bradbn/pelms-2024-s1/README.md

# pelms-2024-s1
Portable Electroluminescence Measurement System for Photovoltaic Modules - Semester 1 2024

## Cloning Repository
To clone this repository, type the following:

`git clone https://github.com/bradbn/pelms-2024-s1.git`
