bradbn/pelms-2024-s1/docs/PELMS/PELMS-2023-S1/SharePoint/Documents/Design Documentation/Software/Software Design Documentation.docx

1. Overview
2. Photo-taking algorithm

Title: "Development and Performance Evaluation of a Portable Electroluminescence Measurement System for Photovoltaic Modules: A Raspberry Pi and Image Processing Approach"

Goals:

1. **Efficient Image Capture**: Develop software that can effectively control a Raspberry Pi Camera module to capture high-quality images of photovoltaic modules under varying power conditions.

2. **Image Comparison and Analysis**: Implement image processing techniques that can accurately compare and analyze the captured images to detect differences in electroluminescence.

3. **Usability**: Create software that is user-friendly and can be operated in both automatic and manual modes, allowing for adjustable parameters like ISO, waiting time, and resolution.

4. **Performance Evaluation**: Validate the software through rigorous testing to ensure that it meets the specified performance criteria and can reliably detect defects in photovoltaic modules.

5. **Scalability**: Design the software to be easily adaptable and upgradeable for future improvements, such as capturing 12-bit images, improving image quality, and allowing for longer exposure times.

Guidelines:

1. **Modular Design**: Keep the design modular to promote easy maintenance and future enhancements.

2. **Code Quality**: Ensure the code is well-documented, maintainable, and follows good coding practices.

3. **Error Handling**: Implement robust error handling to ensure the software handles unforeseen conditions gracefully.

4. **User Interface**: Prioritize usability in the design, making sure that all features and options are intuitive and easy to understand.

5. **Performance Optimization**: Optimize the software to minimize image capture and processing time without sacrificing quality.

6. **Testing and Validation**: Regularly test and validate the software throughout its development to ensure it meets all specified goals and performance criteria.

Result:

The code successfully utilized the Raspberry Pi Camera to capture images under different power conditions, and then computed the difference between these images. The average difference was then output as an image, providing a visual representation of the variations caused by changes in power conditions. This allowed for an in-depth comparison of images taken under different power conditions, with a particular focus on the electroluminescence effect in photovoltaic modules.

The generated difference images (electroluminescence images) were found to be highly effective in highlighting defects in photovoltaic modules. The defects were visible as areas with a significant difference in electroluminescence, allowing for easy identification and further investigation.

Conclusion:

In conclusion, the project has successfully met its objectives by effectively leveraging a Raspberry Pi Camera and image processing techniques to evaluate the impact of electroluminescence on photovoltaic modules. The image comparison methodology employed not only enabled a clear understanding of the variations caused by different power conditions but also facilitated the detection of defects in the photovoltaic modules with a high degree of accuracy.

The quality of the captured images and the generated difference images were commendable, offering easy visualization and interpretation of results. The project demonstrated robustness and reliability by consistently delivering accurate results, even under varying power conditions. The user-friendly design, offering both manual and automatic modes, adds to the usability of the tool in different scenarios, enhancing its potential for real-world applications.

The satisfactory performance of the project against all benchmarked performance criteria underscores its potential utility in the field of photovoltaic module manufacturing and quality control. The capability to accurately identify defects could contribute significantly to the improvement of photovoltaic module reliability and efficiency, which is of paramount importance in the energy industry.

This project serves as a valuable proof of concept demonstrating the effectiveness of using image processing techniques for electroluminescence analysis in photovoltaic modules. Future work could focus on further improving the speed and efficiency of image processing, as well as exploring the application of more sophisticated image comparison and defect detection algorithms to enhance the accuracy and sensitivity of defect detection.

3. RF module configuration
4. GUI design
