bradbn/pelms-2024-s1/docs/PELMS/PELMS-2023-S1/SharePoint/Documents/Reports/Final Documents/Poster/Showcase Presentation.pptx

## Haha funny no longer need this Showcase Presentation: Portable Electroluminescence

Team Solar
Andrew Leong (u6283651) | Levi Zhang (u6972739)
Balaji Radhakrishnan (u7322353) | Yixin Lu (u7411857)
Bhargav Ashok (u7172176) | Zhengdao Zhou (u6706891)

## Electroluminescence of Solar Panels

- Intro into what EL for solar panels is and why its important

## Existing Methods

- Current way of doing things, requiring low lighting conditions and high cost equipment

## Project Objectives

- Problem we are trying to solve and the scope

## Method

- How project has delivered value
- Stakeholders
- Systems Engineering?

## Portable Camera System

## Current Limiter

## Prototype

## Demonstration

## Initial Results

## Rooms for Improvement

## Questions?
