bradbn/pelms-2024-s1/docs/PELMS/SMA Connectors.docx

RP-SMA Female connector on the PCB to an RP-SMA Male on the antenna base.

Want an RP-SMA Male elbow to reduce the height on the RPi.

RP-SMA Male Elbow to RP-SMA Female

https://garmade.com/products/rp-sma-male-elbow-to-rp-sma-female-rg174-rf-coaxial-adapter-cable-length-15cm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

https://mobspares.com/products/rp-sma-male-elbow-to-rp-sma-female-rg174-rf-coaxial-adapter-cable-length-15cm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

https://www.aliexpress.com/item/33004721412.html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
