bradbn/pelms-2024-s1/docs/PELMS/PELMS-2023-S1/SharePoint/Meetings/Client meetings/Meeting Note_05_05_2023.docx

Meeting Notes

Meeting Agenda –Meeting with Chris to continue building our circuit and finalise design and connections with the various components

Meeting Attendance:

Balaji Radhakrishnan (u7322353)

Bhargav Ashok (u7172176)

The other team member’s presence was not necessary since the physical circuit is being developed by the electrical team.

Meeting Notes: | Meeting Duration ~ 120 minutes

The agenda for the meeting was to start the electrical work associated with circuit.

Balaji R began by completing the connections for the Diode and Mosfet, as well as attaching the chip to the copper clad board. Bhargav A started building the various connections associated with the circuit and adding the necessary resistors, capacitors and inductors to ensure the circuit is able to ensure current can be safely passed. Below is image showing the development of the circuit connections to the chip.

Meeting Outcomes:

1. Completed initial connections to the Mosfet, Diode and chip
2. Completed the resistor, capacitor and inductors connections to the design

Current Deliverables:

Continue electrical work and complete the connections for resistor, capacitor and inductor

Finalise the design associated with the circuit

Appendix:

Below is an image of the circuit developed during the meeting

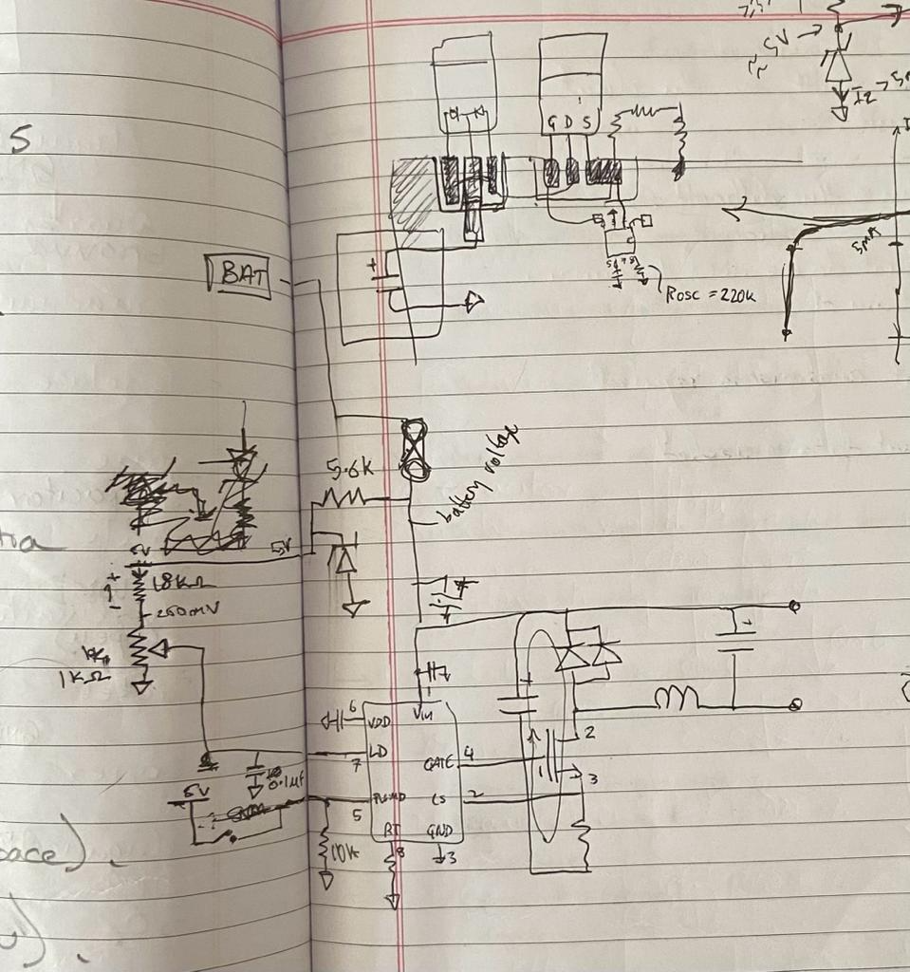
[picture p102: figure]
