bradbn/pelms-2024-s1/docs/PELMS/PELMS-2024-S1/READING/Bayer capture and processing with the Raspberry Pi HQ camera in Python _ by Eric Bezzam _ Medium.pdf

# Bayer capture and processing with the Raspberry Pi HQ camera in Python

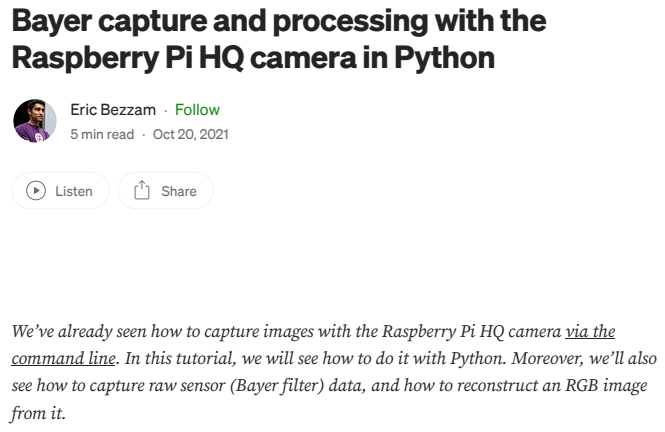
[picture p156: page 1]
Listen; Share

Eric Bezzam (https://medium.com/@bezzam?source=post_page-----8496fed9dcb7--------------------------------) · Follow (https://medium.com/m/signin?operation=register&user=Eric+Bezzam&userId=1c7c74e61a34)
5 min read · Oct 20, 2021

We’ve already seen how to capture images with the Raspberry Pi HQ camera via the
command line. In this tutorial, we will see how to do it with Python. Moreover, we’ll (https://medium.com/@bezzam/headless-raspberry-pi-hq-camera-setup-and-focusing-258ac5cca5ea) also
see how to capture raw sensor (Bayer filter) data, and how to reconstruct an RGB image
from it.

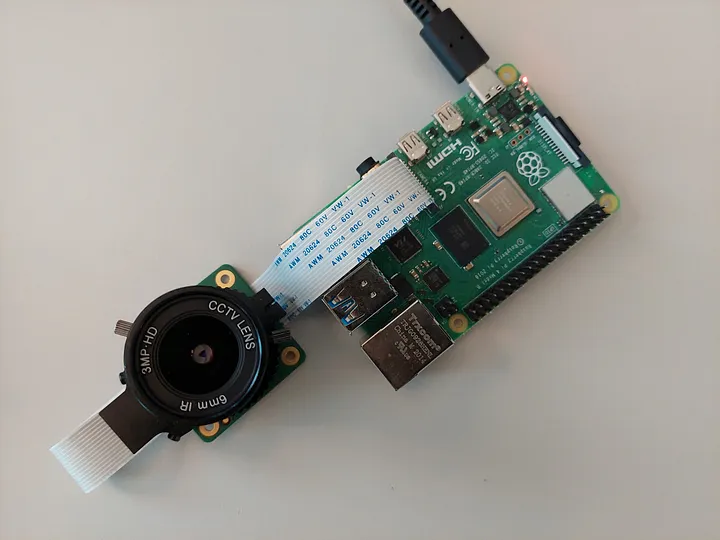
[picture p157: figure]

Before you start:

Your Raspberry Pi should be flashed (https://medium.com/@bezzam/setting-up-a-raspberry-pi-without-a-monitor-headless-9a3c2337f329) with Buster OS as Bullseye does not support the Python package ( picamerax (https://github.com/labthings/picamerax) ) used to interface with the camera!

A lens should be fitted and focused; we’ll use a 6mm CS-mount lens as shown here. (https://medium.com/@bezzam/headless-raspberry-pi-hq-camera-setup-and-focusing-258ac5cca5ea)
Image capture in Python
In a previous tutorial, (https://medium.com/@bezzam/headless-raspberry-pi-hq-camera-setup-and-focusing-258ac5cca5ea) we saw how to capture images with the Raspberry Pi HQ camera via the command line.

raspistill -o test.jpg

For automation purposes, it may be of interest to trigger acquisitions from a scripting language such as Python. To this end, the library PiCameraX (https://picamerax.readthedocs.io/en/latest/) provides some useful functionality in order to configure camera settings (e.g. resolution, frame rate, exposure, ISO, etc).

PiCameraX can be installed via pip (note that the package requires Python 3.2 or above):

pip install picamerax

The following script captures an image to a file.

If you’re working remotely, you can copy over the file as such:

scp pi@raspberrypi.local:/home/pi/test.jpg .

simple_capture.py (https://gist.github.com/ebezzam/4bdef8f5ec2e159012837bb4deba7490#file-simple_capture-py) hosted with ❤ by GitHub (https://github.com/) | view raw (https://gist.github.com/ebezzam/4bdef8f5ec2e159012837bb4deba7490/raw/6cb8713e36a2f51e55b6c80bc91ce4a446b70a5c/simple_capture.py)
1 | from time import sleep
2 | from picamerax import PiCamera
3
4 | camera = PiCamera()
5 | camera.resolution = (1024, 768)
6 | # Camera warm-up time
7 | sleep(2)
8 | camera.capture('test.jpg')

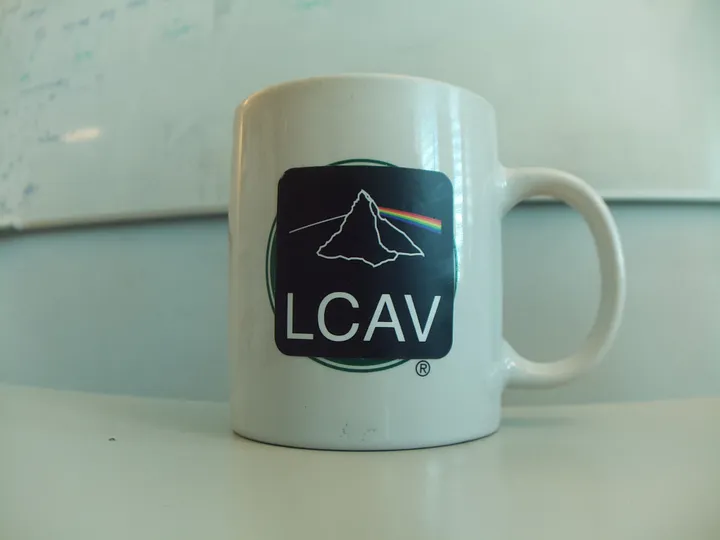
[picture p158: figure]

And that’s it! Different recipes can be found on the PiCameraX documentation page (basic (https://picamerax.readthedocs.io/en/latest/recipes1.html) and advanced). (https://picamerax.readthedocs.io/en/latest/recipes2.html)
Capturing Bayer data via Python
For the rest of this tutorial, we will focus on Bayer data capture, for which PiCameraX offers some functionality. (https://github.com/labthings/picamerax/blob/5f5255a054973cceb42460fd535e980955520e44/picamerax/array.py) Bayer data is the raw data measured by the camera sensor before any GPU processing: demosaicing, color balancing, vignette compensation, smoothing, down-scaling, etc. Wikipedia (https://en.wikipedia.org/wiki/Bayer_filter) provides a good overview about Bayer data / filters. For certain applications, we may require the raw Bayer data, as it has minimal non-linear processing and we can have full control over any subsequent processing.

A Bayer filter consists of a grid of red, green, and blue pixels with twice as many green pixels. On the HQ camera, the pixels are arranged in a BGGR pattern, as shown below.

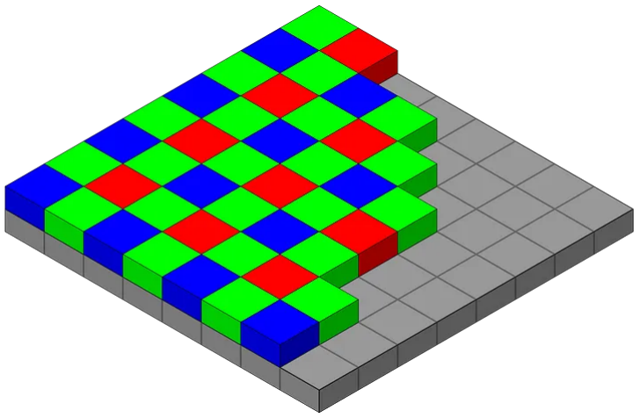
[picture p159: figure]

Source: https://en.wikipedia.org/wiki/Bayer_filter#/media/File:Bayer_pattern_on_sensor.svg

That means if you were to simply extract the red, green, and blue channels from the Bayer data in order to form an RGB image, the resulting image would be too green. Interpolation methods can be used to combine the different pixel values in order to create a more natural-looking image. This process of building a full color image from a color filter array (CFA) such as Bayer is known as demosaicing. (https://en.wikipedia.org/wiki/Demosaicing)

PiCameraX has a recipe (https://picamerax.readthedocs.io/en/latest/recipes2.html#raw-bayer-data-captures) for capturing the Bayer data and demosaicing, which we’ve modified below to have the image as a PNG file.

bayer_capture.py (https://gist.github.com/ebezzam/f3375e937d7535742e3927bd2bccf6f9#file-bayer_capture-py) hosted with ❤ by GitHub (https://github.com/) | view raw (https://gist.github.com/ebezzam/f3375e937d7535742e3927bd2bccf6f9/raw/c4902cefa5dff8863db302739595e22b72380e41/bayer_capture.py)
1 | import picamerax
2 | import picamerax.array
3 | import numpy as np
4 | from PIL import Image
5
6 | with picamerax.PiCamera() as camera:
7 | with picamerax.array.PiBayerArray(camera) as stream:
8 | camera.capture(stream, 'jpeg', bayer=True)
9 | output = (stream.demosaic() >> 2).astype(np.uint8)
10 | img = Image.fromarray(output)
11 | img.save("test_bayer.png")

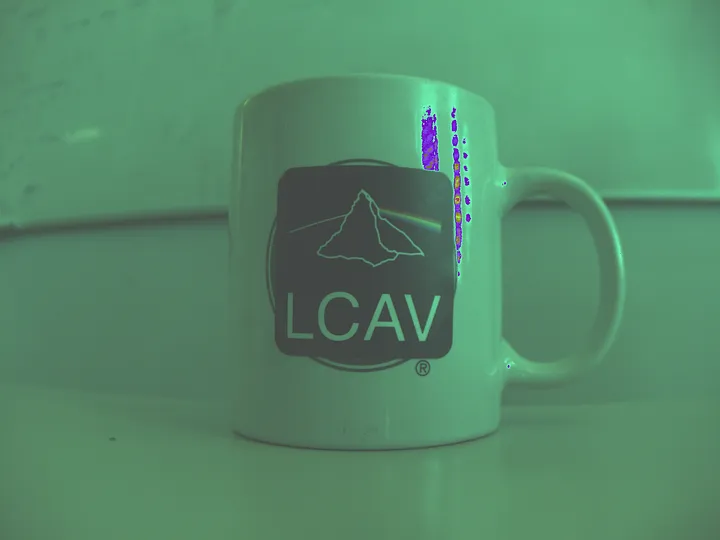
[picture p160: figure]

Not so great😞

The purple traces seem to be indicative of clipping, and we still need color balancing in order to adjust red, green, and blue levels appropriately. PiCameraX (https://en.wikipedia.org/wiki/Color_balance) doesn’t offer such functionality so we will show how to do this in order to get a natural-looking image, as well as deal with clipping.
From Bayer to RGB
We’ll have quite a few differences and additions compared to the PiCameraX recipe. Specifically we will:
Collect | uint16 | data as the HQ camera supports 12 bit raw data. Moreover, we
need to use OpenCV in order to save 16 bit RGB data. Note that OpenCV expects channels in the BGR format. (https://learnopencv.com/why-does-opencv-use-bgr-color-format/)

Use OpenCV’s demosaicing algorithm, which uses bilinear interpolation (bottom of these docs). (https://docs.opencv.org/4.5.3/d8/d01/group__imgproc__color__conversions.html) Note that OpenCV also has a particular way to define Bayer filter patterns, (https://docs.opencv.org/3.4.15/de/d25/imgproc_color_conversions.html) using the second row, second and third column sub-pixels colors to define the layout. So the conversion for our case is COLOR_BayerRG2RBG (https://docs.opencv.org/3.4.15/d8/d01/group__imgproc__color__conversions.html) .

Apply color balancing using red and blue gains estimated by the Raspberry Pi’s AWB (automatic white balance) algorithm. More info on this can be found in Section 5.7 of their documentation.

Apply a color correction matrix (CCM), Section 5.11 of the Raspberry Pi camera documentation. (https://datasheets.raspberrypi.com/camera/raspberry-pi-camera-guide.pdf)

This recipe, largely inspired by this blog (https://www.strollswithmydog.com/open-raspberry-pi-high-quality-camera-raw/) (which also provides the black level to subtract and the CCM values), can be found below.

from time import sleep
import picamerax
import picamerax.array
import numpy as np
import cv2

camera = picamerax.PiCamera()

# get gains for white balancing sleep(2)

awb_gains = camera.awb_gains camera.awb_mode = "off"
camera.awb_gains = awb_gains

# perform capture

stream = picamerax.array.PiBayerArray(camera) camera.capture(stream, "jpeg", bayer=True)

# get raw Bayer data

n_bits = 12
output = np.sum(stream.array, axis=2).astype(np.uint16)

# demosaicing

rgb = cv2.cvtColor(output, cv2.COLOR_BayerRG2RGB)

# subtract black level

black_level = 256.3
rgb = rgb - black_level

# white balance

rgb[:, :, 0] *= float(awb_gains[0]) rgb[:, :, 2] *= float(awb_gains[1])

# color correction

M = np.array(
[
[2.0659, -0.93119, -0.13421], [-0.11615, 1.5593, -0.44314], [0.073694, -0.4368, 1.3636],
]
)
rgb_flat = rgb.reshape(-1, 3, order="F")
rgb = (rgb_flat @ M.T).reshape(rgb.shape, order="F")

# clip

rgb = rgb / (2 ** n_bits - 1 - black_level) rgb[rgb > 1] = 1

Running the above recipe, we would…still not get an natural-looking image.

Perceptual adjustments
There are two reasons behind this very dark image:

Our image data is 12 bit but we are storing it as 16 bits so we are not using the full dynamic range.

Our eyes do not perceive light the way cameras do, i.e. we perceive light in a non-linear fashion as shown below.

bayer capture processed py hosted with ❤ by GitHub | view raw
48 | rgb[rgb > 1] = 1
49 | rgb[rgb < 0] = 0
50 | output = (rgb * (2 ** n_bits - 1)).astype(np.uint16)
51
52 | # save
53 | cv2.imwrite("test_bayer_corrected.png", cv2.cvtColor(output, cv2.COLOR_RGB2BGR))

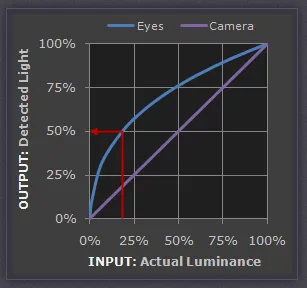
[picture p161: figure]

Source: https://www.cambridgeincolour.com/tutorials/gamma-correction.htm

In order to account for this perception mismatch, we need to apply gamma correction and normalize before visualizing the image. (https://www.cambridgeincolour.com/tutorials/gamma-correction.htm)

Applying solely normalization produces a much more pleasing image.

save_normalized_image.py (https://gist.github.com/ebezzam/77fa3c5e2c9ad3691ccdcd341a2218c0#file-save_normalized_image-py) hosted with ❤ by GitHub (https://github.com/) | view raw (https://gist.github.com/ebezzam/77fa3c5e2c9ad3691ccdcd341a2218c0/raw/98983f43431937cd8a1edfede8adcd71bb65f99f/save_normalized_image.py)

import cv2
from PIL import Image
import numpy as np

# need OpenCV to open 16 bit RGB

fp = "test_bayer_corrected.png"
img = cv2.imread(fp, cv2.IMREAD_UNCHANGED) img = cv2.cvtColor(img, cv2.COLOR_BGR2RGB)

# normalize and save

img_float = img / img.max()
data = 255 * img_float
img_uint8 = data.astype(np.uint8) Image.fromarray(img_uint8).save("normalized.png")

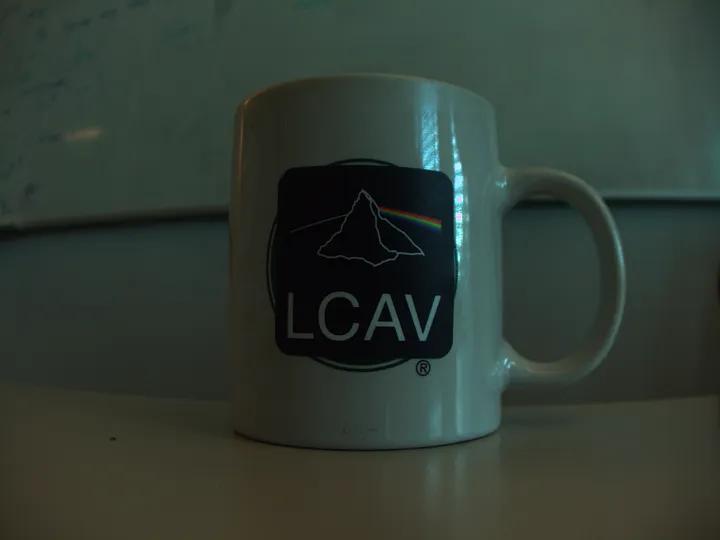
[picture p162: figure]

But the image is still rather dark, and the colors don’t match our real world perception.

Gamma correction will remedy this discrepancy. To this end, there are some simple approaches, but we will use the Rec. 709 standard: (https://lindevs.com/apply-gamma-correction-to-an-image-using-opencv/)

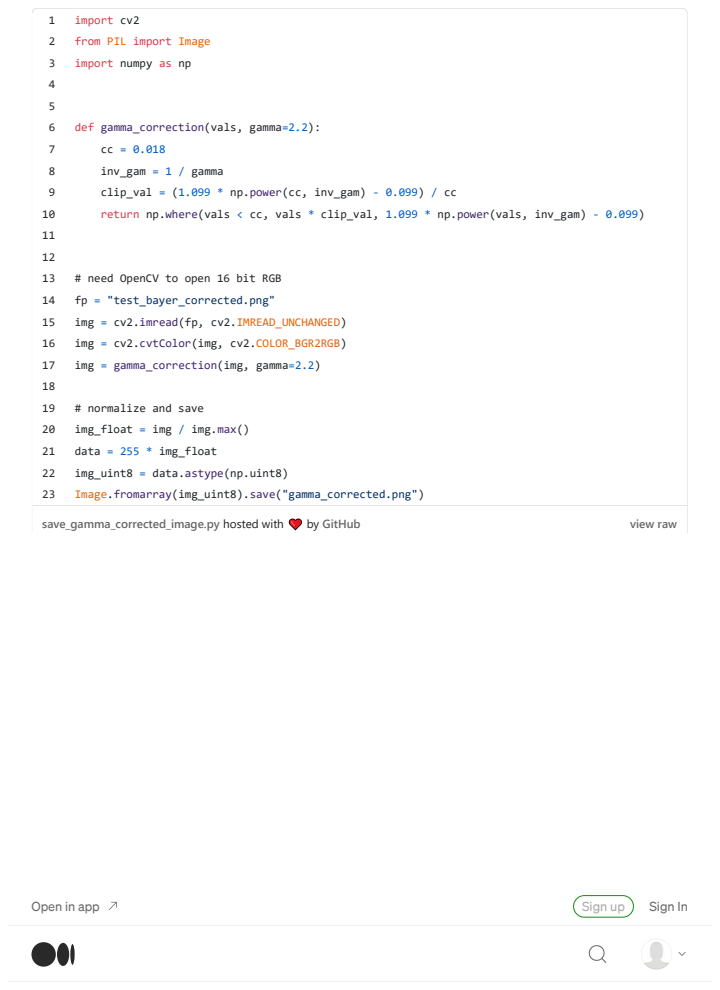
[picture p163: page 12]
save_gamma_corrected_image.py hosted with ❤ by GitHub; view raw; import cv2; from PIL import Image; import numpy as np; def gamma_correction(vals, gamma=2.2):; inv_gam = 1 / gamma; clip_val = (1.099 * np.power(cc, inv_gam) - 0.099) / cc; return np.where(vals < cc, vals * clip_val, 1.099 * np.power(vals, inv_gam) - 0.099); # need OpenCV to open 16 bit RGB; fp = "test_bayer_corrected.png"; img = cv2.imread(fp, cv2.IMREAD_UNCHANGED); img = cv2.cvtColor(img, cv2.COLOR_BGR2RGB)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

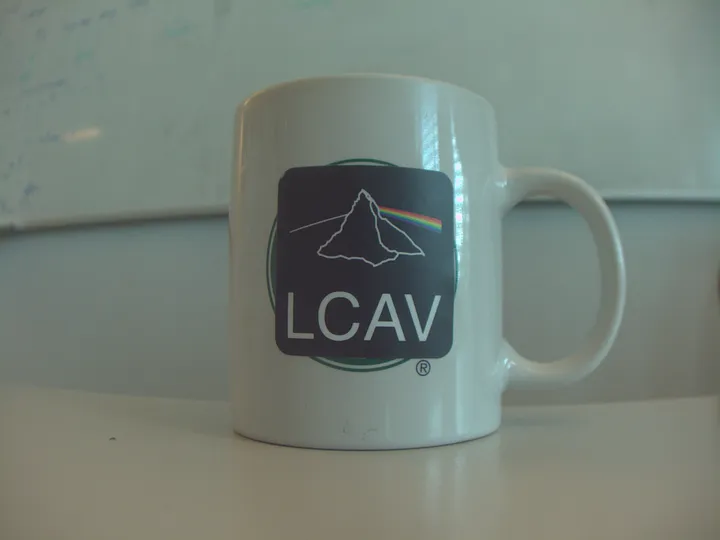
[picture p164: figure]

That looks much better😎
Extra links
Official post by Raspberry Pi: https://www.raspberrypi.com/news/processing-raw-image-files-from-a-raspberry-pi-high-quality-camera/ (https://www.raspberrypi.com/news/processing-raw-image-files-from-a-raspberry-pi-high-quality-camera/)

Stolls with my Dog has also done a very thorough analysis of the HQ camera performance: https://www.strollswithmydog.com/pi-hq-cam-sensor-performance/

Getting raw Bayer data without PiCameraX on the Bullseye OS: https://www.raspberrypi.com/documentation/accessories/camera.html#raw-image-capture (https://www.raspberrypi.com/documentation/accessories/camera.html#raw-image-capture)

Bayer (https://medium.com/tag/bayer?source=post_page-----8496fed9dcb7---------------bayer-----------------) | Python (https://medium.com/tag/python) | Raspberry Pi (https://medium.com/tag/raspberry-pi) | Color Correction (https://medium.com/tag/color-correction) | Gamma Correction (https://medium.com/tag/gamma-correction)

Written by Eric Bezzam (https://medium.com/@bezzam?source=post_page-----8496fed9dcb7--------------------------------)

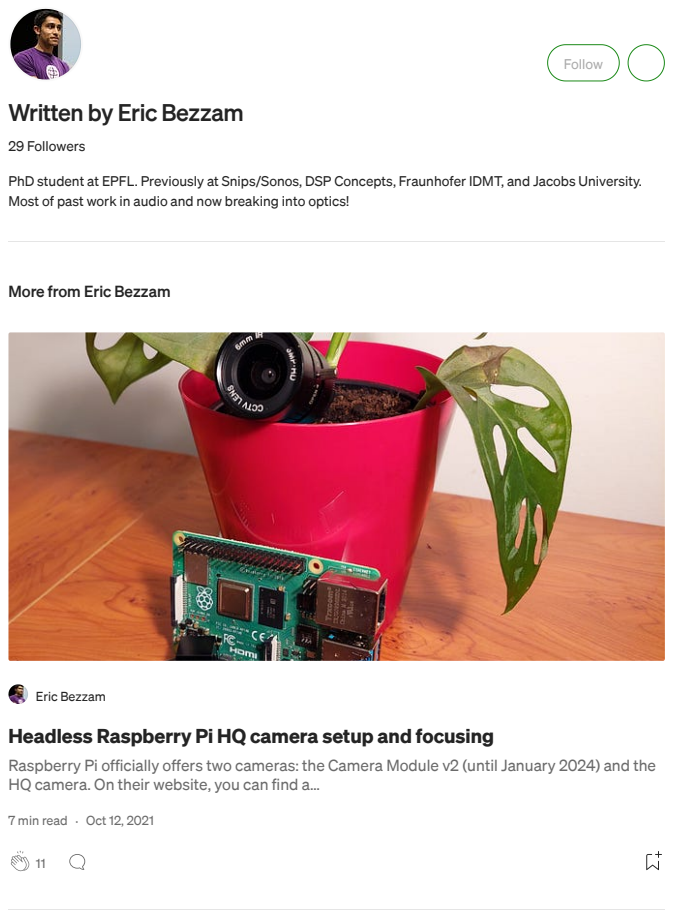
[picture p165: page 14]
Follow; 29 Followers

PhD student at EPFL. Previously at Snips/Sonos, DSP Concepts, Fraunhofer IDMT, and Jacobs University.
Most of past work in audio and now breaking into optics!

More from Eric Bezzam

Eric Bezzam (https://medium.com/@bezzam)
Headless Raspberry Pi HQ camera setup and focusing
Raspberry Pi officially offers two cameras: the Camera Module v2 (until January 2024) and the
HQ camera. On their website, you can find a…

7 min read · Oct 12, 2021 (https://medium.com/@bezzam/headless-raspberry-pi-hq-camera-setup-and-focusing-258ac5cca5ea)

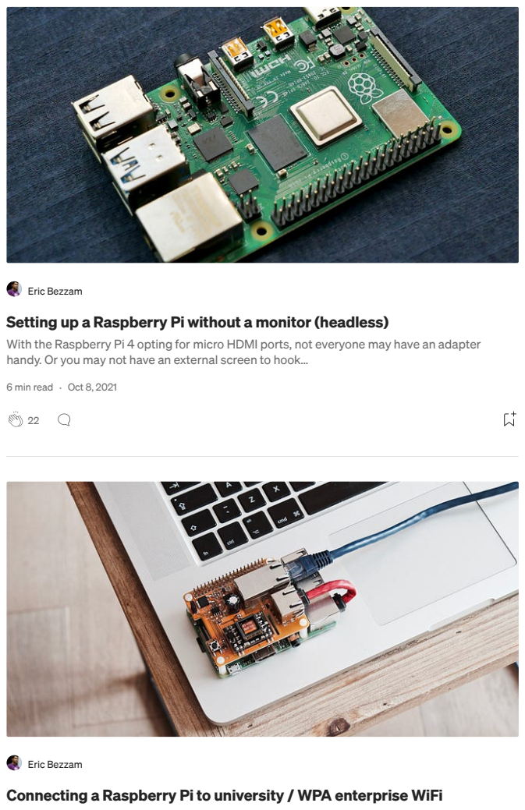
[picture p166: page 15]

Eric Bezzam (https://medium.com/@bezzam)
Setting up a Raspberry Pi without a monitor (headless)
With the Raspberry Pi 4 opting for micro HDMI ports, not everyone may have an adapter
handy. Or you may not have an external screen to hook…

6 min read · Oct 8, 2021 (https://medium.com/@bezzam/setting-up-a-raspberry-pi-without-a-monitor-headless-9a3c2337f329)

Connecting a Raspberry Pi to university / WPA enterprise WiFi (https://medium.com/@bezzam/connecting-a-raspberry-pi-to-university-wpa-enterprise-wifi-532d4b203056)

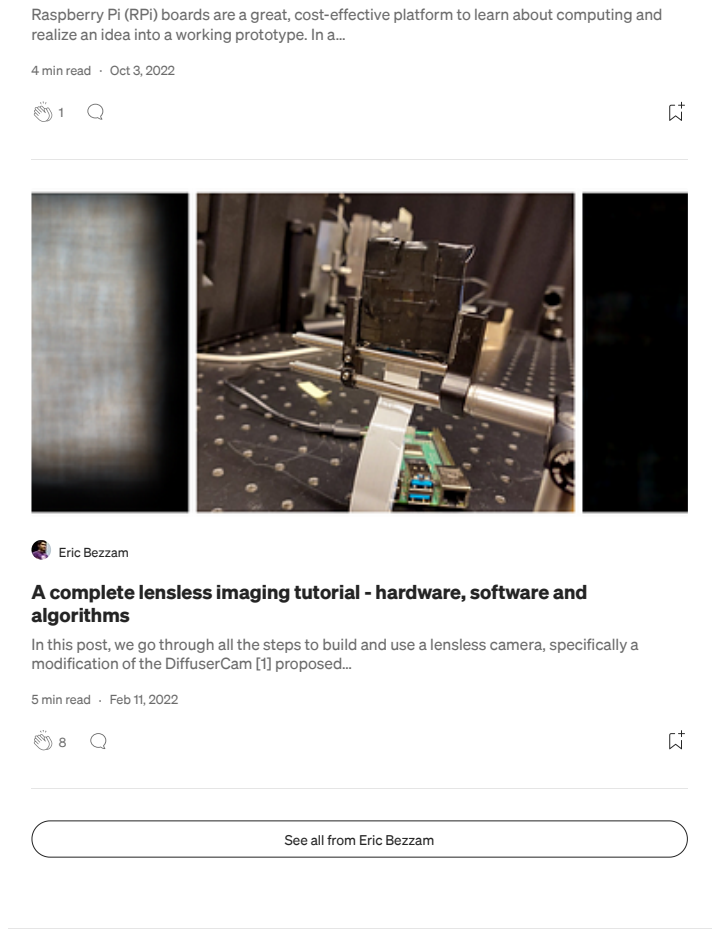
[picture p167: page 16]

Raspberry Pi (RPi) boards are a great, cost-effective platform to learn about computing and
realize an idea into a working prototype. In a…

4 min read · Oct 3, 2022 (https://medium.com/@bezzam/connecting-a-raspberry-pi-to-university-wpa-enterprise-wifi-532d4b203056)

Eric Bezzam (https://medium.com/@bezzam)
A complete lensless imaging tutorial - hardware, software and
algorithms
In this post, we go through all the steps to build and use a lensless camera, specifically a
modification of the DiffuserCam [1] proposed…

5 min read · Feb 11, 2022 (https://medium.com/@bezzam/a-complete-lensless-imaging-tutorial-hardware-software-and-algorithms-8873fa81a660)

See all from Eric Bezzam (https://medium.com/@bezzam?source=post_page-----8496fed9dcb7--------------------------------)

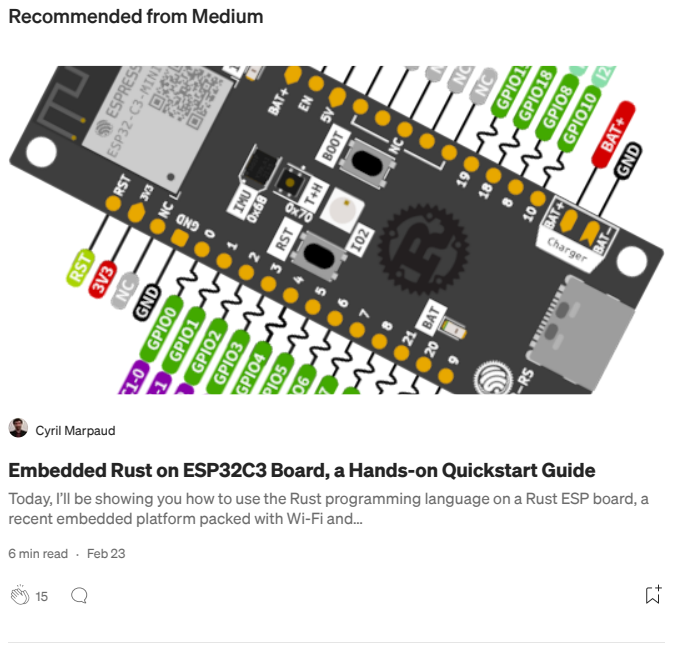
[picture p168: page 17]

Recommended from Medium

Cyril Marpaud (https://medium.com/@cyril.marpaud)
Embedded Rust on ESP32C3 Board, a Hands-on Quickstart Guide
Today, I’ll be showing you how to use the Rust programming language on a Rust ESP board, a
recent embedded platform packed with Wi-Fi and…

6 min read · Feb 23 (https://medium.com/@cyril.marpaud/embedded-rust-on-esp32c3-board-a-hands-on-quickstart-guide-a20fe5ff9b4b)

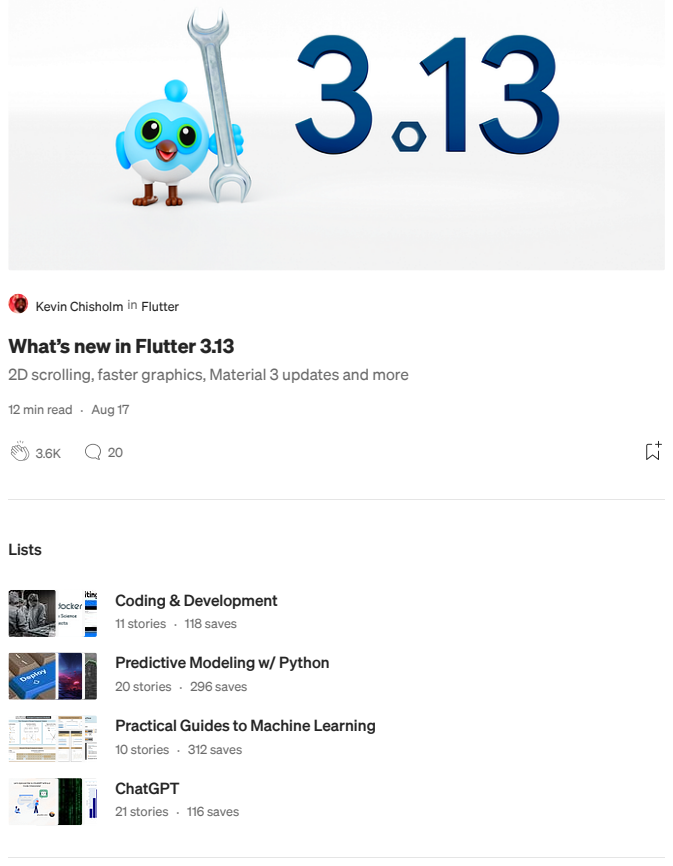
[picture p169: page 18]
Lists; Coding & Development; 11 stories · 118 saves; ChatGPT; 21 stories · 116 saves

Kevin Chisholm (https://medium.com/@kevinchisholm) in Flutter (https://medium.com/flutter)
What’s new in Flutter 3.13
2D scrolling, faster graphics, Material 3 updates and more

12 min read · Aug 17 (https://medium.com/flutter/whats-new-in-flutter-3-13-479d9b11df4d)

Predictive Modeling w/ Python
20 stories · 296 saves (https://medium.com/@ben.putney/list/predictive-modeling-w-python-e3668ea008e1)

Practical Guides to Machine Learning
10 stories · 312 saves (https://medium.com/@destingong/list/practical-guides-to-machine-learning-a877c2a39884)

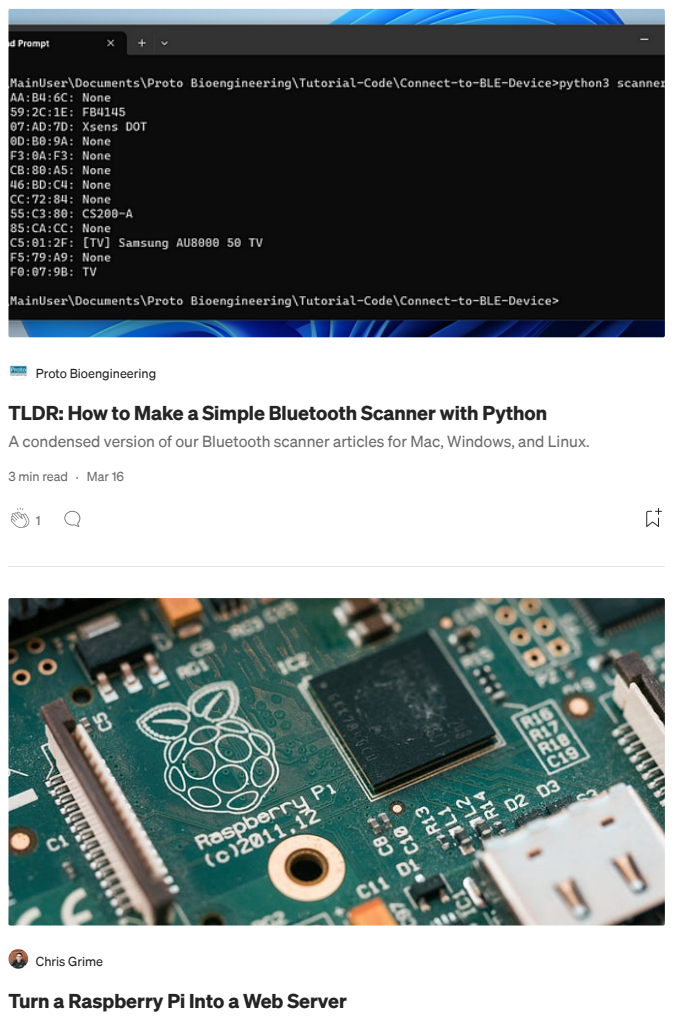
[picture p170: page 19]

Proto Bioengineering (https://medium.com/@protobioengineering)
TLDR: How to Make a Simple Bluetooth Scanner with Python
A condensed version of our Bluetooth scanner articles for Mac, Windows, and Linux.

3 min read · Mar 16 (https://medium.com/@protobioengineering/tldr-how-to-make-a-simple-bluetooth-scanner-with-python-99023152110e)

Chris Grime (https://medium.com/@chrisgrime)
Turn a Raspberry Pi Into a Web Server (https://medium.com/@chrisgrime/turn-a-raspberry-pi-into-a-web-server-ea7f395e6fe8)

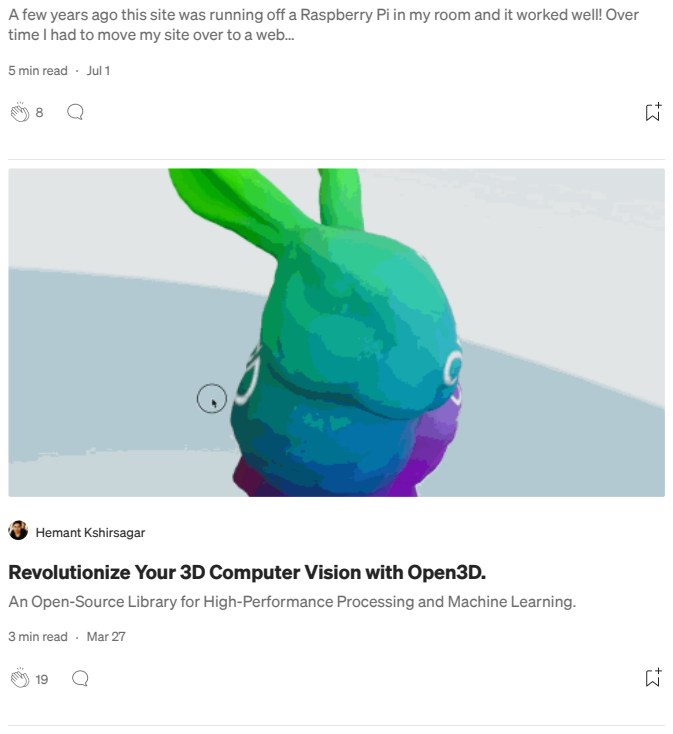
[picture p171: page 20]

A few years ago this site was running off a Raspberry Pi in my room and it worked well! Over
time I had to move my site over to a web…

5 min read · Jul 1 (https://medium.com/@chrisgrime/turn-a-raspberry-pi-into-a-web-server-ea7f395e6fe8)

Hemant Kshirsagar (https://medium.com/@hemantkshirsagar8)
Revolutionize Your 3D Computer Vision with Open3D.
An Open-Source Library for High-Performance Processing and Machine Learning.

3 min read · Mar 27 (https://medium.com/@hemantkshirsagar8/open3d-an-open-source-3d-computer-vision-library-ff65bae4f1b6)

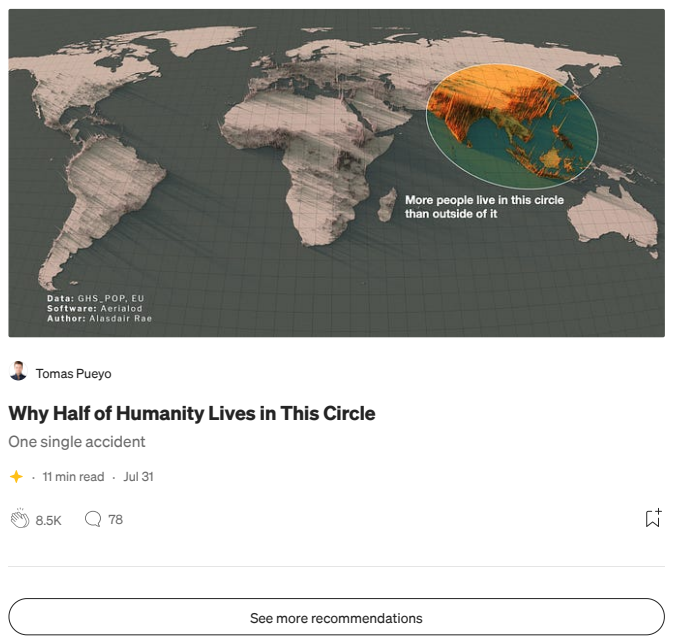
[picture p172: page 21]

Tomas Pueyo (https://medium.com/@tomaspueyo)
Why Half of Humanity Lives in This Circle
One single accident

· 11 min read · Jul 31 (https://medium.com/@tomaspueyo/why-half-of-humanity-live-in-this-circle-2c25be0994ce)

See more recommendations (https://medium.com/?source=post_page-----8496fed9dcb7--------------------------------)
