bradbn/pelms-2024-s1/docs/PELMS/PELMS-2023-S1/SharePoint/Documents/Reports/Final Documents/Final Team Review/Final Team Review.pdf

## Development of a Portable Electroluminescence Measurement System for Photovoltaic Modules

### Final Team Review

Team Solar:

Andrew Leong (u6283651)

Balaji Radhakrishnan (u7322353)

Bhargav Ashok (u7172176)

Levi Zhang (u6972739)

Yixin Lu (u7411857)

Zhengdao Zhou (u6706891)

i

## Table of Contents

## 1. Grade Band Recommendation

The team recommends a grade band of D-HD, specifically 80±5. The team views the overall work done by the team as “Acceptable to Exemplary”, leaning more on the “Exemplary” half. This is based on the analysis of the team’s performance shown in this document. To summarise the project, the team has produced an iterated and fully functional prototype that satisfies the requirements of the project. The team achieved this through informed and timely decision-making paired with excellent teamwork, and effective internal and external communications to support the development of the project. Furthermore, throughout the duration of the project, the team has implemented a regular and systematic reflection process that promotes diverse contributions and ideas. Lastly, the team has embraced the TechLauncher opportunity and has produced an informative, easy to read, and detailed showcase poster that showcases the prototype made by the team. To summarise the assessment of the project throughout the semester, the Audit indications for each of the 3 Audits are as follows:
Audit | Indicator
1 | Acceptable without reservations
2 | Acceptable without reservations
3 | Acceptable without reservations
The indicators given for each criterion in each audit are summarised below. The indicators have ranged from “Acceptable” to “Acceptable to Exemplary”. After reviewing all the work done by the team, the final recommendations in this document for each criterion range from “Acceptable” to “Exemplary”. This is also summarised below.
Criteria | Audit 1 | Audit 2 | Audit 3 | Recommendation
Project Output | Acceptable (2) | Acceptable (2) | Acceptable (2) | Acceptable to Exemplary (2.5)
Decision Making | Acceptable (2) | Acceptable to Exemplary (2.5) | Acceptable to Exemplary (2.5) | Acceptable (2)
Teamwork | Acceptable (2) | Acceptable to Exemplary (2.5) | Acceptable to Exemplary (2.5) | Acceptable to Exemplary (2.5)
Communication | Acceptable (2) | Acceptable to Exemplary (2.5) | Acceptable (2) | Acceptable to Exemplary (2.5)
Reflection | NA | Acceptable to Exemplary (2.5) | Acceptable (2) | Acceptable to Exemplary (2.5)
Design Visualisation | NA | NA | Acceptable to Exemplary (2.5) | Exemplary (3)
Average | Acceptable (2) | Acceptable (2.4) | Acceptable (2.25) | Acceptable to Exemplary (2.5)

Scoring system to determine indicator: Baseline = 1, Acceptable = 2, Exemplary = 3

## 2. Project Output

Based on the criteria, the team views Project Output on an “Acceptable to Exemplary” level. This is because the team has designed a technical solution, (https://anu365.sharepoint.com/:f:/s/PortableELdeviceProject/EvQWbpjs0pJOsftg4p_D9MgBEOkHponi8Z745BOjIGUilg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) built a fully functional prototype with 2 iterations, (https://anu365.sharepoint.com/:f:/s/PortableELdeviceProject/Eoc-iB0crvFNoao1u1XH4a8B1kk-3fmiuuEpKuHgtan8ag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) and presented the prototype to the client. (https://anu365.sharepoint.com/:w:/s/PortableELdeviceProject/EX5XOumdyPhItu-ioBck_MkBh3wD7E5bSjJZx5mDuR2bPQ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) The prototype has been tested by the team, (https://anu365.sharepoint.com/:w:/s/PortableELdeviceProject/EeiCXKnrMuhPqkqb3clWI6ABm7-c48Y0UzBP-9WEu32e9Q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) consulting electrical engineer, and client (technical expert) who have endorsed the system (https://anu365.sharepoint.com/:w:/s/PortableELdeviceProject/EX5XOumdyPhItu-ioBck_MkBh3wD7E5bSjJZx5mDuR2bPQ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) and its outputs twice. Furthermore, the prototype will be validated against the requirements in the technical report using the TPMs (https://anu365.sharepoint.com/:w:/s/PortableELdeviceProject/EW6kXEsJgw1MtgVOZHuq4oUB4-NetXl08SbPeES7-XkNrA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) but the document has not been finalised yet. Finally, the prototype surpasses the crash goals and met half of the stretch goals. (https://anu365.sharepoint.com/:w:/s/PortableELdeviceProject/ETmNM39qWipAvuR9MBurf-wBB3p5IgDRSEnYhcRk3RpKQg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) This is because the solution was designed following a systems engineering framework (https://anu365.sharepoint.com/:w:/s/PortableELdeviceProject/EW6kXEsJgw1MtgVOZHuq4oUB4-NetXl08SbPeES7-XkNrA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) where the system requirements (subsystem requirements encapsulated within high level requirements) were defined early, followed by design and construction to meet those requirements, and then by verifying the results against the requirements. The criteria that do not apply to the team are regarding the commercialisation, publication, grant funding, external validation report, and conference presentation. This is because the team does not own the IP (https://anu365.sharepoint.com/:f:/s/PortableELdeviceProject/EmUgFAes4pdMpxZanxT0aW0BLqX25ZbzKsxKDGuc_MDKkw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) to the system and therefore cannot produce any publications or commercialise the solution to receive funding, present at conferences or get external validation reports. The only criteria not met by the team is the real-world user testing and validation. This is because the team completed prototyping towards the end of the project and had no opportunity to perform real-world user testing.

## 3. Decision Making

Based on the criteria, the team views Decision Making on an “Acceptable” level. This is because the team has used a systematic method for recording decisions through clear and concise meeting minutes. (https://anu365.sharepoint.com/sites/PortableELdeviceProject/Shared%20Documents/Repository%20Documents/Meetings) Furthermore, the team has exhibited transparent communication within the team and with the client, (https://anu365.sharepoint.com/sites/PortableELdeviceProject/Shared%20Documents/Repository%20Documents/Meetings/Client%20meetings) teaching staff, and shadow by being open about the state of the project and any challenges faced such as the unexpected complexity of current regulator. The team has a centralised group chat for internal communication, with much of the external communication facilitated through the Project Coordinator. The team has also utilised systemic document revisions. (https://anu365.sharepoint.com/sites/PortableELdeviceProject/Shared%20Documents/Repository%20Documents/Archives) Furthermore, the team executed this project through the use of a systems engineering V-model (https://anu365.sharepoint.com/sites/PortableELdeviceProject/Shared%20Documents/Repository%20Documents/Documents/Reports/Systems%20Engineering%20Document.docx) that guided decision-making as decisions always related to the requirements. The team also had an inclusive decision-making process as there was feedback in Audit 1 (https://anu365.sharepoint.com/sites/PortableELdeviceProject/Shared%20Documents/Repository%20Documents/Audits/Audit%201/Team%20Solar%20Audit%201%20Feedback%20R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) about the need for a better internal process. The team then committed to consulting with everybody before making a decision (https://anu365.sharepoint.com/sites/PortableELdeviceProject/Shared%20Documents/Repository%20Documents/Meetings/Team%20meetings) as opposed to only the sub-team focused on the task. The criteria that the team did not meet was our decision-making process aligning with relevant standards, however, the team did ensure the components used aligned with relevant standards. This is because the team had operated on a system agreed upon by the team as detailed in the ConOps. (https://anu365.sharepoint.com/sites/PortableELdeviceProject/Shared%20Documents/Repository%20Documents/Audits/Audit%201/Concept%20of%20Operations_V2.docx) The team also did not utilise a decision log and recorded decisions only in meeting minutes.

## 4. Teamwork

Based on the criteria, the team views Teamwork on an “Acceptable to Exemplary” level. This is because early on in the project, the team designated specialist roles and defined the responsibilities by embracing the diverse skill set of each member. (https://anu365.sharepoint.com/sites/PortableELdeviceProject/Shared%20Documents/Repository%20Documents/Audits/Audit%201/Concept%20of%20Operations_V2.docx) Furthermore, the team agreed that the roles were not set in stone as members would rotate around the team dependent on which area required more support. The team also defined a conflict resolution style (https://anu365.sharepoint.com/sites/PortableELdeviceProject/Shared%20Documents/Repository%20Documents/Audits/Audit%201/Concept%20of%20Operations_V2.docx) early on but was lucky to not require it. The team began to build support around the project from experts as early as 10th March (Week 3). (https://anu365.sharepoint.com/sites/PortableELdeviceProject/Shared%20Documents/Repository%20Documents/Meetings/Client%20meetings/Meeting%20Note_10_03_2023.docx) This process allowed team members to grow and develop new skills. An excellent example of this is when Balaji who has a Mechanical background (https://u6283651.wixsite.com/luminescent/theteam) had the opportunity to learn soldering from the consulting electrical engineer. As such, Balaji ended up working primarily on the electrical component which transcends his background. (https://anu365.sharepoint.com/sites/PortableELdeviceProject/Shared%20Documents/Repository%20Documents/Meetings/Client%20meetings/Meeting%20Note_03_05_2023.docx) The team faced failures during the prototyping phase. The team embraces the failures as an opportunity to learn such as when the camera algorithm was not working as intended and when the current regulator had a heating issue. The team solved each issue as a team and through guidance from the established support network of experts. (https://anu365.sharepoint.com/sites/PortableELdeviceProject/Shared%20Documents/Repository%20Documents/Meetings/Client%20meetings/Meeting%20Note_10_05_2023.docx) The only criteria not met by the team was reducing uncertainty as the team operated in two sub-teams for the prototyping process and only collaborated towards the end, increasing the risk of non-integration.

## 5. Communication

Based on the criteria, the team views Communication on an “Acceptable-Exemplary” level. This is because the team believes they have displayed transparent, relevant, timely, (https://anu365.sharepoint.com/:f:/s/PortableELdeviceProject/EjZlpGgrjjNAsti9WQHueykBstz7aLVZv4q9tdzYRbe-jg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)

professional, respectful, and effective communication with all stakeholders. (https://anu365.sharepoint.com/:f:/s/PortableELdeviceProject/EjZlpGgrjjNAsti9WQHueykBstz7aLVZv4q9tdzYRbe-jg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) The team also utilises a systems vocabulary in all documents (https://anu365.sharepoint.com/:f:/s/PortableELdeviceProject/En7LODS6IWRPvkaLmvwSAZIBUgBt842cFSmqoSUwA5t5Fg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) and whenever talking about the project as evident in the tutorials and in the meeting minutes. (https://anu365.sharepoint.com/:f:/s/PortableELdeviceProject/EjZlpGgrjjNAsti9WQHueykBstz7aLVZv4q9tdzYRbe-jg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) For communication with stakeholders, the Project Coordinator has been tasked with facilitating the process. This enables professional communication as there is a sole person of contact which removes any confusion. Furthermore, the team utilises systematic process such as scheduled meetings with all stakeholders and through consistent modes of communication such as emails and MS Teams. From the beginning of the project, the team has created a shared vision (https://anu365.sharepoint.com/:p:/s/PortableELdeviceProject/ERyY0lC-l9xMqLlC3LmRd-QBFE-jqLmwYoOr_l_PnkWbDw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) of the project through consultation with the client. This resulted in trust being built with the most important stakeholder. The criteria not met by the team include the common mental models of practice because members operated best at their own pace and method but would come together and finalise the work as a team. Next, empowering members to engage with new audiences was also not achieved as there was no opportunity to engage with more external stakeholders.

## 6. Reflection

Based on the criteria, the team views Reflection on an “Acceptable-Exemplary” level. This is because the team has a system for reflection and acting on feedback. The team achieves this through the feedback response documents for Audit 1 (https://anu365.sharepoint.com/:x:/s/PortableELdeviceProject/EQdGeAx7SRNLjjdi_ipPsOUBd4l3q1ZKwP09ypyYj01RpQ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) and 2. (https://anu365.sharepoint.com/:x:/s/PortableELdeviceProject/ETFuamvw1qlNt3o21RT7BpEBmJpwo6iqsYmRv5RSlI1mQg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) In this document, the team analyses and summarises all the feedback given during the Audit process and responds to each one. The team either acts on the feedback immediately, agrees to act on the feedback, or rejects the feedback due to relevance. In this process, the team respects the viewpoints of all members as well as the shadow and teach staff who gave feedback through open discussion. Furthermore, the team consults with the client and electrical engineer (https://anu365.sharepoint.com/:f:/s/PortableELdeviceProject/Elaha2Veb-NPp8PWUfBZqFgB60ga_5SphIiH1gDQAqfZnA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) for advice regarding the feedback received. This allows for mentoring and gaining external validation for how well the team is progressing. The team also actively engages with the other teams and clients during the tutorial to provide any feedback where possible through open discussions. The only criteria not met by the team is the additional review process that includes external stakeholders. The team had initially planned on iterating the prototype after conducting user testing with ANU Solarcar to determine how functional and user friendly the system is. However, the client stated that it would only be done if a functioning system was completed in time but as the prototype phase taking longer than expected, this was not achieved.

## 7. Design Visualisation

Based on the criteria, the team views Design Visualisation on an “Exemplary” level. This is because the showcase poster (https://anu365.sharepoint.com/:b:/s/PortableELdeviceProject/ETj4-YrcmaRKhXOzDAQ8jjkBe7b6WZY6Ru83IfhG9QD_8A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) designed by the team clearly states the motivations for the project, the work done and results achieved, and details the opportunities for new audiences in a coherent, uncluttered, and visually pleasing manner. In the poster, the team also highlights which stakeholders the project delivers value to and complements the information with a functional physical prototype. In the poster, the team has built a story that flows from the current pains of the stakeholders to the accomplishments of the team, and to the opportunities allowed for by the designed solution. This story is told in as non-technical language as possible to appeal to a broad audience and allows for discussions to occur with the team, supplemented by physical prototypes and demonstration videos, to help build an understanding within the new audiences. Furthermore, the team iterated on the poster (https://www.canva.com/design/DAFi8uVkguM/3pyQNzxX5gXxXdIzKEhu_g/edit) to produce a concise and informative poster. The criteria that do not apply to the team is the demonstrates individual contributions criterion as a techlauncher poster should focus more on the holistic work done by the team, and the acts on opportunities for new audiences as the team is able to commercialise the product due to the IP being owned by the client.

Supporting Evidence
Project Output
- Technical Solution: Design Documentation (https://anu365.sharepoint.com/:f:/s/PortableELdeviceProject/EvQWbpjs0pJOsftg4p_D9MgBEOkHponi8Z745BOjIGUilg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)
- Fully functional 2 prototypes: Results (https://anu365.sharepoint.com/:f:/s/PortableELdeviceProject/Eoc-iB0crvFNoao1u1XH4a8B1kk-3fmiuuEpKuHgtan8ag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)
- Presented prototype 1 to client, validated by client and experts: Meeting minutes 15_05_2023.docx (https://anu365.sharepoint.com/:w:/s/PortableELdeviceProject/EX5XOumdyPhItu-ioBck_MkBh3wD7E5bSjJZx5mDuR2bPQ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)
- Tested by team: Meeting minutes 14_05_2023.docx (https://anu365.sharepoint.com/:w:/s/PortableELdeviceProject/EeiCXKnrMuhPqkqb3clWI6ABm7-c48Y0UzBP-9WEu32e9Q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)
- Systems Engineering Framework: Systems Engineering Document.docx (https://anu365.sharepoint.com/:w:/s/PortableELdeviceProject/EW6kXEsJgw1MtgVOZHuq4oUB4-NetXl08SbPeES7-XkNrA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)
- IP agreement: IP Agreement (https://anu365.sharepoint.com/:f:/s/PortableELdeviceProject/EmUgFAes4pdMpxZanxT0aW0BLqX25ZbzKsxKDGuc_MDKkw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)

Decision Making

- Meeting minutes : Meetings (https://anu365.sharepoint.com/:f:/s/PortableELdeviceProject/EjZlpGgrjjNAsti9WQHueykB9ZxyTYLF9lR92RQSy7w-tg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)
Centralised group chat | Transparent communication with the team and client, facilitated by project co-ordinator Andrew Leong

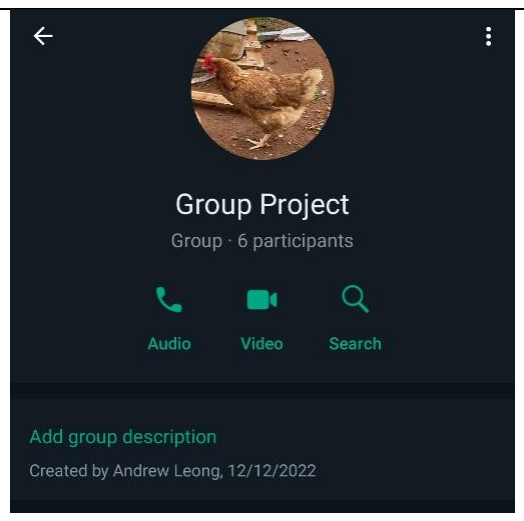
[picture p173: figure]
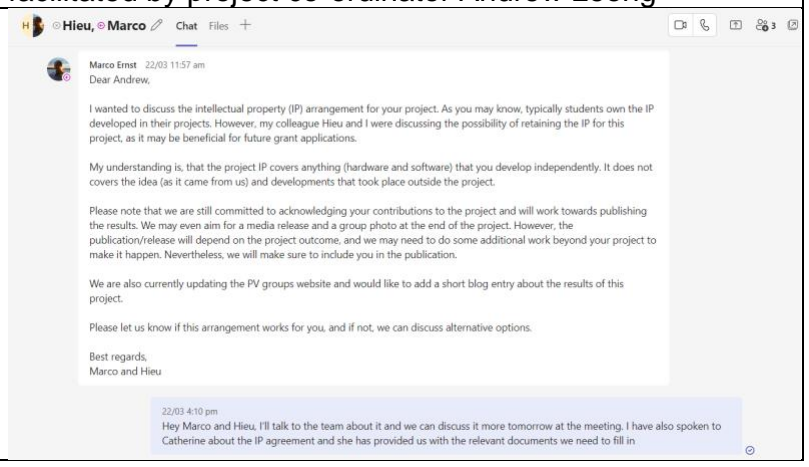
[picture p174: figure]

- Document revision: Archives (https://anu365.sharepoint.com/:f:/s/PortableELdeviceProject/ElB5jKOlBRhDh6uxH15I_FwBvGNifPKFpD_2w4w1omBNcw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)
- System engineering V-Model: Systems Engineering Document.docx (https://anu365.sharepoint.com/:w:/s/PortableELdeviceProject/EW6kXEsJgw1MtgVOZHuq4oUBj-1ZYOthkqZe2ekhR4kVqQ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)
- Decision making process for feedback audit 1: Team Solar Audit 1 Feedback Response.xlsx (https://anu365.sharepoint.com/:x:/s/PortableELdeviceProject/EQdGeAx7SRNLjjdi_ipPsOUB7Mll2pL836L-HOvRfnH32g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)
- Making a decision: Team meetings (https://anu365.sharepoint.com/:f:/s/PortableELdeviceProject/EuPXh58dGHFBkmqoJM7Lrt4B40UEYmuKO9xaoNbWZEqb5Q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)
- ConOps: Concept of Operations_V2.docx (https://anu365.sharepoint.com/:w:/s/PortableELdeviceProject/ETmNM39qWipAvuR9MBurf-wBzu14Pwa_Fnz8mBw9upJbcw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)

Teamwork

- Specialist roles and defined the responsibilities by embracing the diverse skill set of each member: Concept of Operations_V2.docx (https://anu365.sharepoint.com/:w:/s/PortableELdeviceProject/ETmNM39qWipAvuR9MBurf-wBzu14Pwa_Fnz8mBw9upJbcw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)
- Conflict resolution style: Concept of Operations_V2.docx (https://anu365.sharepoint.com/:w:/s/PortableELdeviceProject/ETmNM39qWipAvuR9MBurf-wBzu14Pwa_Fnz8mBw9upJbcw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)
- From experts as early as 10th March (Week 3): Meeting Note_10_03_2023.docx (https://anu365.sharepoint.com/:w:/s/PortableELdeviceProject/ER0vzaapu7RJphI1XjWHFc8BWsPSLvj7xMVCgE4EfLcabQ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)
- Mechanical Background: Landing page (https://u6283651.wixsite.com/luminescent/theteam)
- Balaji ended up working primarily on the electrical component which transcends his background: Meeting Note_03_05_2023.docx (https://anu365.sharepoint.com/:w:/s/PortableELdeviceProject/EbAlZPrGw1hGlJ9nD3LO6r4B3DJcnCzaQo48aNUVvPqM3Q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)
- Solved each issue as a team and through guidance from the established support network of experts: Meeting Note_10_05_2023.docx (https://anu365.sharepoint.com/:w:/s/PortableELdeviceProject/ETcmF-8Gss9FsuPygaQlJKYBvugaQ2OJsDHVvayTEImt6g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)

Communication

- Effective communication with all stakeholders: Meetings (https://anu365.sharepoint.com/:f:/s/PortableELdeviceProject/EjZlpGgrjjNAsti9WQHueykBstz7aLVZv4q9tdzYRbe-jg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)
- Systems vocabulary in all documents: Documents (https://anu365.sharepoint.com/:f:/s/PortableELdeviceProject/En7LODS6IWRPvkaLmvwSAZIBUgBt842cFSmqoSUwA5t5Fg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)

Project Coordinator, Andrew, displaying professional communication with client:

Scheduled regular
meetings with client:

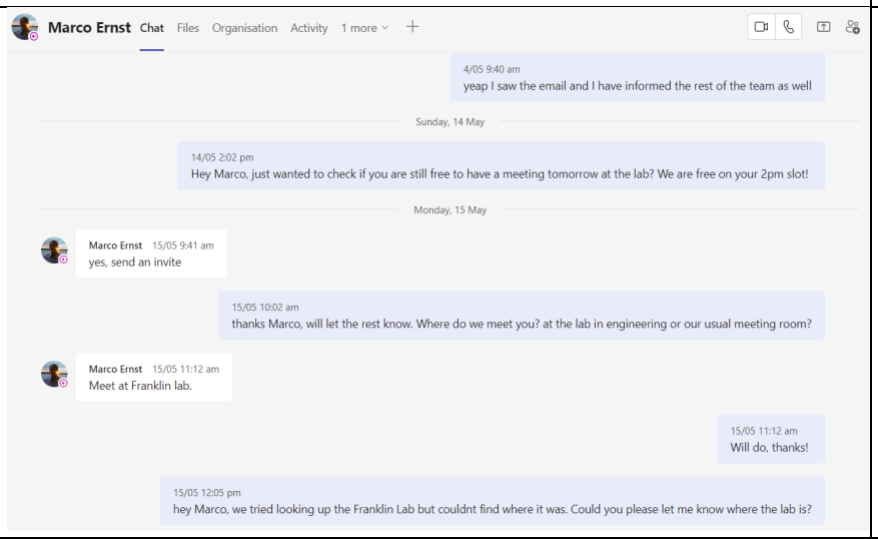
[picture p175: figure]
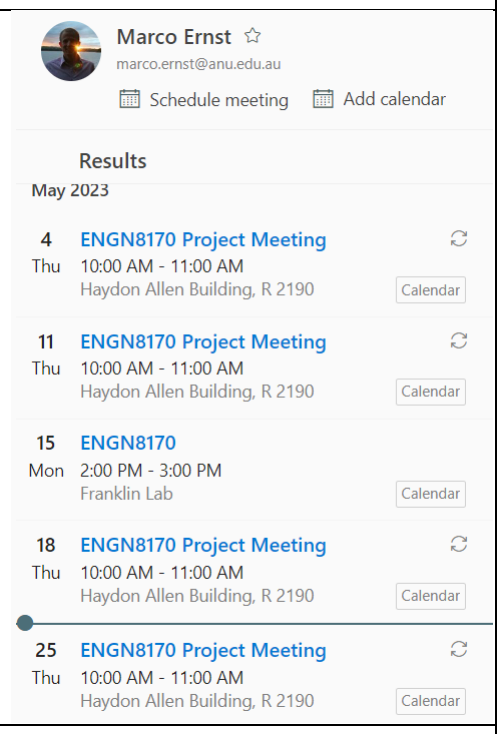
[picture p176: figure]

Plan for contacting ANU Solarcar but depending on progress

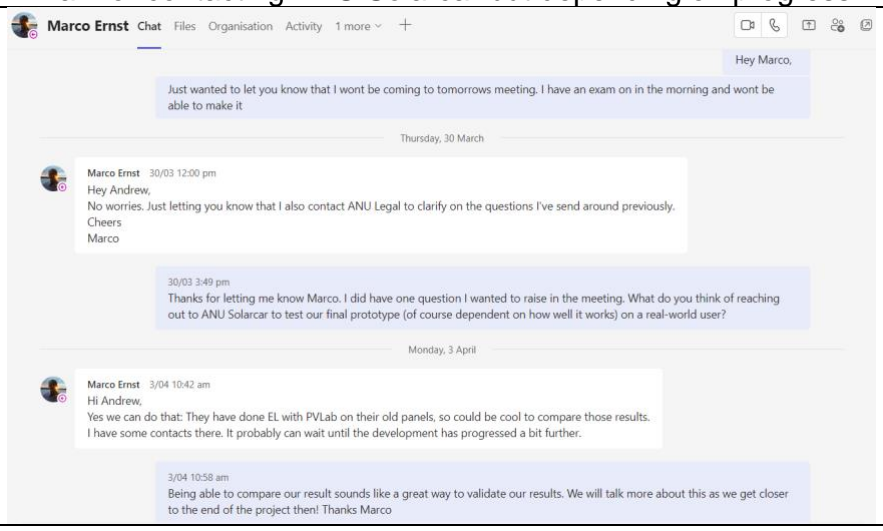
[picture p177: figure]

- Shared vision of the project from early on: Meeting 08_02_2023 Powerpoint .pptx (https://anu365.sharepoint.com/:p:/s/PortableELdeviceProject/ERyY0lC-l9xMqLlC3LmRd-QBFE-jqLmwYoOr_l_PnkWbDw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)

Reflection

- Audit 1 Feedback Response: Team Solar Audit 1 Feedback Response.xlsx (https://anu365.sharepoint.com/:x:/s/PortableELdeviceProject/EQdGeAx7SRNLjjdi_ipPsOUBd4l3q1ZKwP09ypyYj01RpQ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)
- Audit 2 Feedback Response: Team Solar Audit 2 Feedback Response.xlsx (https://anu365.sharepoint.com/:x:/s/PortableELdeviceProject/ETFuamvw1qlNt3o21RT7BpEBmJpwo6iqsYmRv5RSlI1mQg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)
- Team consults clients and experts: Client meetings (https://anu365.sharepoint.com/:f:/s/PortableELdeviceProject/Elaha2Veb-NPp8PWUfBZqFgB60ga_5SphIiH1gDQAqfZnA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)

Design Visualisation

- Showcase Poster: (Submitted to TechLauncher) Final edit.pdf (https://anu365.sharepoint.com/:b:/s/PortableELdeviceProject/ETj4-YrcmaRKhXOzDAQ8jjkBe7b6WZY6Ru83IfhG9QD_8A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)
- Poster iteration process: https://www.canva.com/design/DAFi8uVkguM/3pyQNzxX5gXxXdIzKEhu_g/edit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 (https://www.canva.com/design/DAFi8uVkguM/3pyQNzxX5gXxXdIzKEhu_g/edit)
