bradbn/pelms-2024-s1/docs/PELMS/RPi_PINOUT.PNG

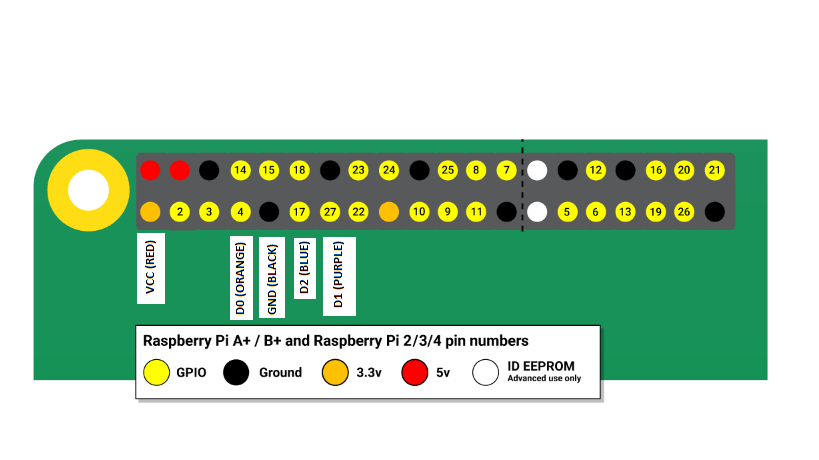
docs/PELMS/RPi_PINOUT.PNG
