bradbn/pelms-2024-s1/docs/PELMS/PELMS-2023-S1/SharePoint/Documents/Research Materials/Raspberry Pi Setting Information.docx

## Raspberry Pi Basic Information:

Username: portableel

Password: ENGN8170

IP Address: 192.168.31.150

VNC and SSH should be turned on. Following are the way to check:

Raspberry Pi Icon → Preferences → Raspberry Pi Configuration

## Environments Setting Instruction:

If the IP Address above is not working, follow the instruction below to get new IP Address

Connect a screen, a mouse, and a keyboard to the Raspberry Pi

Power on the raspberry pi with the official charger

Raspberry Pi Icon → Accessories → Terminal

Enter the command: hostname -I

On the laptop:

Download the VNC Viewer from the following link

VNC Viewer:

https://www.realvnc.com/en/connect/download/viewer/

Open the VNC viewer and skip for signing up

Use the IP address of the raspberry to make a connection between the raspberry pi and the VNC viewer.

After this step, all screens, mouses, and keyboards could be removed from the raspberry pi.
