bradbn/pelms-2024-s1/docs/PELMS/PELMS-2024-S1/BILL_OF_MATERIAL_LISTS/PELMS-2024S1-CR-PCB-FULL_Digikey-List.xlsx

Index | Manufacturer Part Number | Manufacturer Name | Description | Availability | Stock Status | Attrition % | Requested Quantity 1 | Pack Quantity 1 | Pack Type 1 | Digi-Key Part Number 1 | Unit Price 1 | Extended Price 1 | Minimum Order Quantity 1 | Customer Reference | Requested Part Number | Lead Weeks | Datasheet | Reference Designator | US Import Tariff | Note | Part Status | RoHS Status | Moisture Sensitivity Level (MSL) | ECCN | HTSUS | Country of Origin | Environmental Information | Original Part numbers | Image | Product Notes
1 | EKY-101ELL681ML40S | Chemi-Con | CAP ALUM 680UF 20% 100V RADIAL | 154 | In Stock |  | 1 | 1 | Bulk | 565-EKY-101ELL681ML40S-ND | 2.91000 | $2.91 | 1 |  | 565-EKY-101ELL681ML40S-ND | 28 | https://www.chemi-con.co.jp/products/relatedfiles/capacitor/catalog/KY-LL-e.PDF | C1 | N/A | C1 | Active | ROHS3 Compliant | Not Applicable | EAR99 | 8532.22.0020 | Japan |  | 565-EKY-101ELL681ML40S-ND | https://mm.digikey.com/Volume0/opasdata/d220001/medias/images/2586/KY%20SERIES%2040H%2C12.5D.jpg
2 | FG20X7S2A475KRT06 | TDK Corporation | CAP CER 4.7UF 100V X7S RADIAL | 2,006 | In Stock |  | 2 | 2 | Cut Tape (CT) | 445-173304-1-ND | 1.24000 | $2.48 | 1 |  | 445-173304-1-ND | 24 | https://product.tdk.com/en/system/files | C2, C3 | May apply on shipments to the U.S. | C2, C3 | Active | ROHS3 Compliant | Not Applicable | EAR99 | 8532.24.0060 | China | https://product.tdk.com/en/environment/index.html | 445-173304-1-ND | https://mm.digikey.com/Volume0/opasdata/d220001/medias/images/21/MFG_FG20.JPG
3 | FG16X5R1H106KRT06 | TDK Corporation | CAP CER 10UF 50V X5R RADIAL | 2,387 | In Stock |  | 1 | 1 | Cut Tape (CT) | 445-173153-1-ND | 1.24000 | $1.24 | 1 |  | 445-173153-1-ND | 24 | https://product.tdk.com/en/system/files | C4 | May apply on shipments to the U.S. | C4 | Active | ROHS3 Compliant | Not Applicable | EAR99 | 8532.24.0060 | China | https://product.tdk.com/en/environment/index.html | 445-173153-1-ND | http://mm.digikey.com/Volume0/opasdata/d220001/medias/images/21/MFG_FG16.JPG
4 | RLB0914-121KL | Bourns Inc. | FIXED IND 120UH 1.05A 320MOHM TH | 756 | In Stock |  | 1 | 1 | Bulk | RLB0914-121KL-ND | 0.44000 | $0.44 | 1 |  | RLB0914-121KL-ND | 18 | https://www.bourns.com/docs/Product-Datasheets/rlb.pdf | L1 | May apply on shipments to the U.S. | L1 | Active | ROHS3 Compliant | Not Applicable | EAR99 | 8504.50.4000 | China | https://www.bourns.com/docs/rohs-content/bourns-reach-letter.pdf|https://www.bourns.com/docs/rohs-cofc/cofc_al.pdf?sfvrsn=b9f3375_8 | RLB0914-121KL-ND | https://mm.digikey.com/Volume0/opasdata/d220001/medias/images/402/RLB0914-SERIES.jpg
5 | LICAL-DEC-MS001-T | TE Connectivity Linx | IC REMOTE CONTROL DECODER 20SSOP | 14,397 | In Stock |  | 1 | 1 | Cut Tape (CT) | 343-LICAL-DEC-MS001-TCT-ND | 8.69000 | $8.69 | 1 |  | 343-LICAL-DEC-MS001-TCT-ND | 52 | https://linxtechnologies.com/wp/wp-content/uploads/lical-dec-ms001.pdf | U1 | N/A | U1 | Active | RoHS Compliant | 1 (Unlimited) | EAR99 | 8542.39.0001 | Thailand | https://linxtechnologies.com/wp/wp-content/uploads/LFRHS_J_170718-Linx-Technologies-RoHS-Certificate-of-Compliance-REACH-SVHC-Statement.pdf | 343-LICAL-DEC-MS001-TCT-ND | https://mm.digikey.com/Volume0/opasdata/d220001/medias/images/376/20-SSOP_SOT266-1.jpg
6 | RXM-433-LR | TE Connectivity Linx | RF RECEIVER ASK/OOK 433MHZ | 884 | In Stock |  | 1 | 1 | Tube | RXM-433-LR-ND | 18.17000 | $18.17 | 1 |  | RXM-433-LR-ND | 40 | https://www.te.com/commerce/DocumentDelivery/DDEController?Action=srchrtrv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 | U3 | N/A | U3 | Active | RoHS Compliant | 1 (Unlimited) | 5A991G | 8527.99.4000 | China | https://linxtechnologies.com/wp/wp-content/uploads/LFRHS_J_170718-Linx-Technologies-RoHS-Certificate-of-Compliance-REACH-SVHC-Statement.pdf | RXM-433-LR-ND | http://mm.digikey.com/Volume0/opasdata/d220001/medias/images/3789/MFG_RXM-433-LR_View2.jpg
7 | HV9910CLG-G | Microchip Technology | IC LED DRIVER CTRLR PWM 8SOIC | 7,099 | In Stock |  | 1 | 1 | Cut Tape (CT) | HV9910CLG-GCT-ND | 0.56000 | $0.56 | 1 |  | HV9910CLG-GCT-ND | 6 | https://ww1.microchip.com/downloads/en/DeviceDoc/20005323A.pdf | U4 | N/A | U4 | Active | ROHS3 Compliant | 1 (Unlimited) | EAR99 | 8542.39.0001 | Thailand | https://ww1.microchip.com/downloads/aemDocuments/documents/corporate-responsibilty/environmental/product-regulatory-information/Semiconductor_EnvCoC.pdf|https://ww1.microchip.com/downloads/aemDocuments/documents/corporate-responsibilty/environmental/product-regulatory-information/Microchip_REACH_Statement.pdf|https://ww1.microchip.com/downloads/aemDocuments/documents/corporate-responsibilty/environmental/product-regulatory-information/Semiconductor_Prop_65_Statemen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 | HV9910CLG-GCT-ND | https://mm.digikey.com/Volume0/opasdata/d220001/medias/images/4844/150_8-SOIC_751.jpg
8 | LP2985-33DBVR | Texas Instruments | IC REG LINEAR 3.3V 150MA SOT23-5 | 136,478 | In Stock |  | 1 | 1 | Cut Tape (CT) | 296-18476-1-ND | 0.52000 | $0.52 | 1 |  | 296-18476-1-ND | 12 | https://www.ti.com/general/docs/suppproductinfo.tsp?distId=10 | U5 | May apply on shipments to the U.S. | U5 | Active | ROHS3 Compliant | 1 (Unlimited) | EAR99 | 8542.39.0001 | China |  | 296-18476-1-ND | https://mm.digikey.com/Volume0/opasdata/d220001/medias/images/4180/296%7E4073253-4%7EDBV%7E5.JPG
