bradbn/pelms-2024-s1/docs/PELMS/PELMS-2024-S1/KICAD/4PCV-06-006/3D/4PCV-06-006.stp

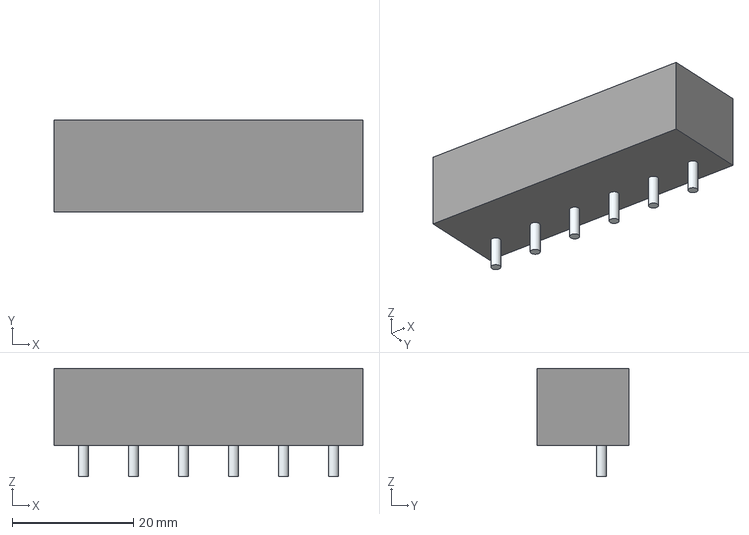
[picture p179: CAD file, 2024-10-21]
docs/PELMS/PELMS-2024-S1/KICAD/4PCV-06-006/3D/4PCV-06-006.stp
50.9 x 15.2 x 17.8 mm
Leads
