bradbn/pelms-2024-s1/docs/PELMS/PELMS-2024-S1/KICAD/HV9910CLG_G/SOIC8_4P9X3P9MC_MCH.step

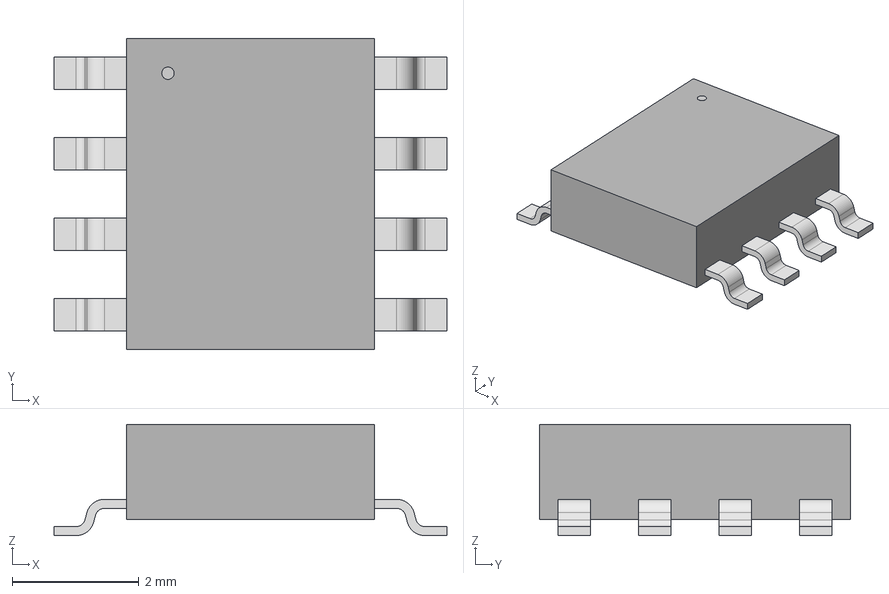
[picture p180: CAD file, 2024-10-21]
docs/PELMS/PELMS-2024-S1/KICAD/HV9910CLG_G/SOIC8_4P9X3P9MC_MCH.step
6.20 x 4.90 x 1.75 mm
