bradbn/pelms-2024-s1/docs/PELMS/PELMS-2024-S1/KICAD/HV9910CNG_G/SOIC16_9P9X3P9MC_MCH.step

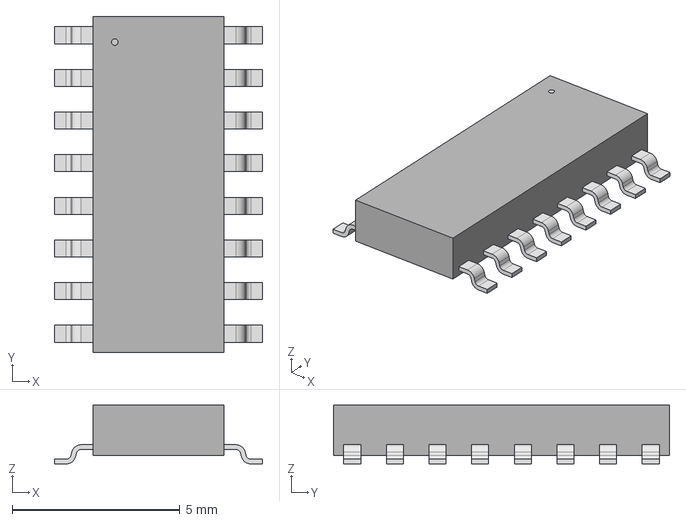
[picture p181: CAD file, 2024-10-21]
docs/PELMS/PELMS-2024-S1/KICAD/HV9910CNG_G/SOIC16_9P9X3P9MC_MCH.step
6.20 x 10.0 x 1.75 mm
