bradbn/pelms-2024-s1/docs/PELMS/PELMS-2024-S1/KICAD/LIB_1711725/1711725/3D/1711725.stp

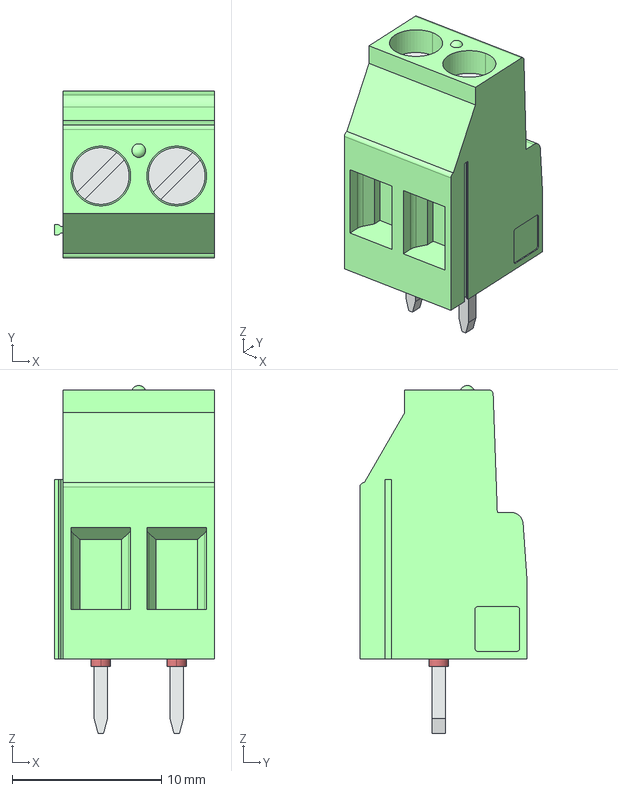
[picture p182: CAD file, 2024-10-21]
docs/PELMS/PELMS-2024-S1/KICAD/LIB_1711725/1711725/3D/1711725.stp
10.7 x 11.2 x 23.3 mm
BOHRLOCHDURCHMESSER_1.PRT
BOHRLOCHDURCHMESSER_2.PRT
MKDS_3-2-5_08.PRT
