bradbn/pelms-2024-s1/docs/PELMS/PELMS-2024-S1/KICAD/LIB_640445-3/640445-3/3D/640445-3.stp

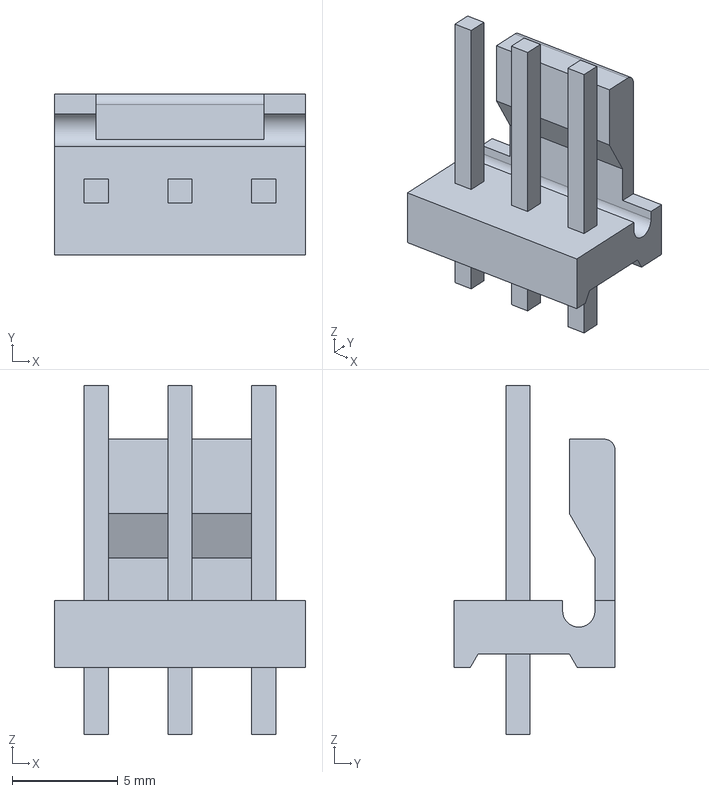
[picture p183: CAD file, 2024-10-21]
docs/PELMS/PELMS-2024-S1/KICAD/LIB_640445-3/640445-3/3D/640445-3.stp
11.9 x 7.62 x 16.5 mm
