bradbn/pelms-2024-s1/docs/PELMS/PELMS-2024-S1/KICAD/LIB_MC000048/MC000048/3D/MC000048.stp

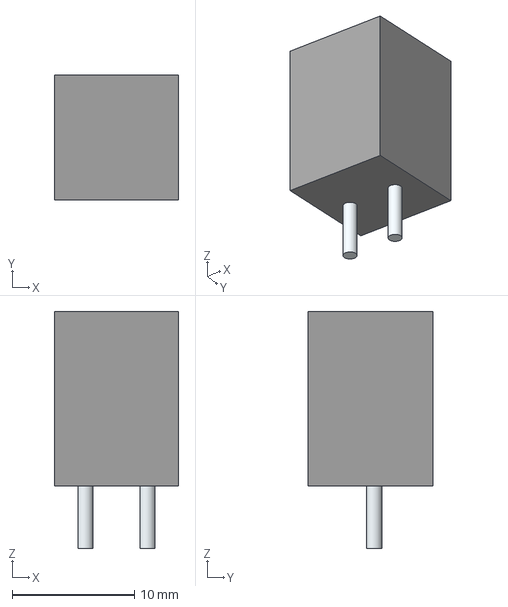
[picture p184: CAD file, 2024-10-21]
docs/PELMS/PELMS-2024-S1/KICAD/LIB_MC000048/MC000048/3D/MC000048.stp
10.2 x 10.2 x 19.4 mm
Leads
