bradbn/pelms-2024-s1/(list of files, cad)

Other CAD files:
docs/PELMS/PELMS-2024-S1/KICAD/4PCV-06-006/Allegro/4pcv06006.psm
docs/PELMS/PELMS-2024-S1/KICAD/4PCV-06-006/DEHDL/4pcv_06_006/chips/chips.prt
docs/PELMS/PELMS-2024-S1/KICAD/LIB_1711725/1711725/Allegro/1711725.psm
docs/PELMS/PELMS-2024-S1/KICAD/LIB_1711725/1711725/DEHDL/1711725/chips/chips.prt
docs/PELMS/PELMS-2024-S1/KICAD/LIB_640445-3/640445-3/Allegro/hdrv3w140p0x396_1x3_1189x762x1689p.psm
docs/PELMS/PELMS-2024-S1/KICAD/LIB_640445-3/640445-3/DEHDL/640445_3/chips/chips.prt
docs/PELMS/PELMS-2024-S1/KICAD/LIB_MC000046/MC000046/Allegro/mc000046.psm
docs/PELMS/PELMS-2024-S1/KICAD/LIB_MC000046/MC000046/DEHDL/mc000046/chips/chips.prt
docs/PELMS/PELMS-2024-S1/KICAD/LIB_MC000048/MC000048/Allegro/mc000048.psm
docs/PELMS/PELMS-2024-S1/KICAD/LIB_MC000048/MC000048/DEHDL/mc000048/chips/chips.prt
