bradbn/pelms-2024-s1/docs/PELMS/PELMS-2023-S1/SharePoint/Documents/Results/Prototype 2/Prototype Documentation.pptx

## Portable Electroluminescence Measurement Device Prototype Documentation

Team Solar

## Prototype 1

## Prototype 1 Subsystems

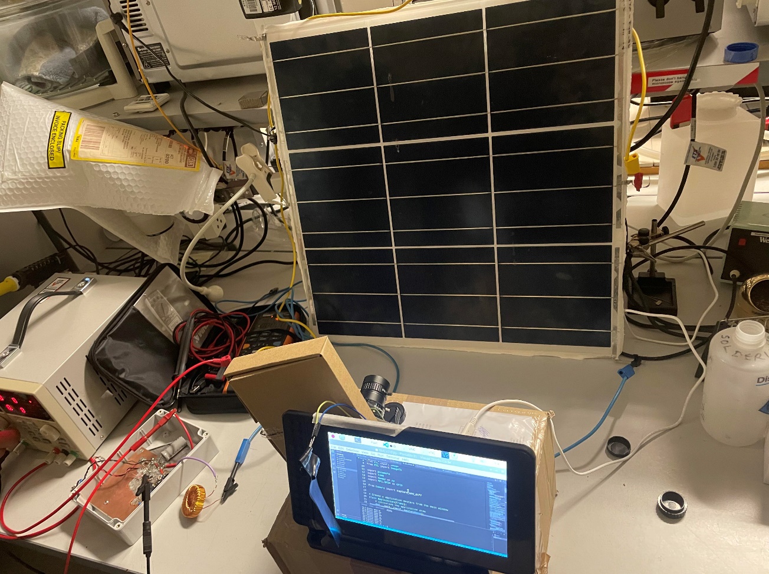
[picture p192: figure]

Camera System

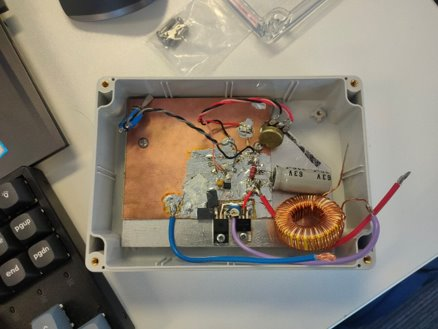
[picture p193: figure]

Current Regulator

## Prototype 1 Demonstration

- Video removed due to size

## Prototype 1 Results

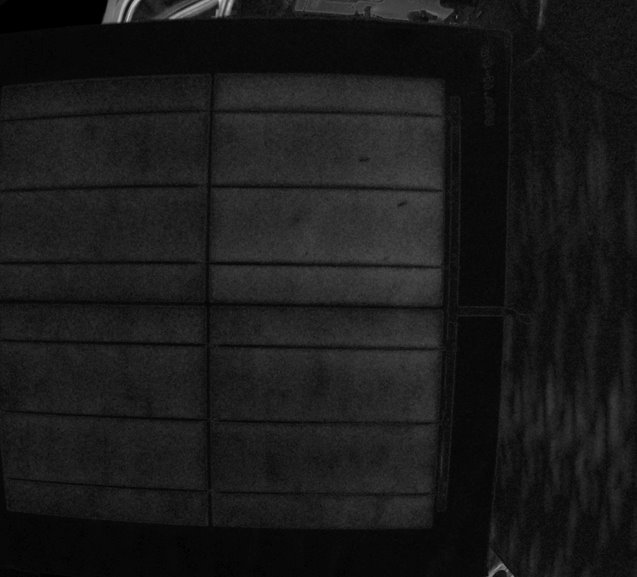
[picture p194: figure]

EL image of 4 cell solar panel

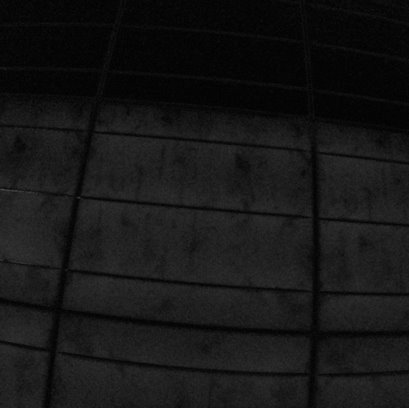
[picture p195: figure]

Power present, EL produced

Validated EL results through partial powering of 9 cell panel

No power, no EL

## Prototype 1 Key Features

- Functional Individual Subsystems
  - Camera Algorithm on Raspberry Pi able to properly time image capture and perform computer vision transformation (minus two image and average over multiple pairs)
  - Raspberry Pi display functional and able to display results
  - Current Regulator able to range current that passes to the panel from 0A to 10A using a potentiometer
- Able to obtain EL image using 10 pairs of images within 3 minutes
- Validated results using 9 cell solar panel by partial powering of the panel and comparing the cells in the image produced.

## Prototype 1 Concerns

- Current regulator step up and step down is a manual process, not controlled by Raspberry Pi
- Current regulator requires multimeter to indicate current to panel
- Current regulator housing container too small to implement wireless RF link
- LED light used to indicate when current is being sent to panel introduces noise to the EL image and affects results
- Control algorithm runs via code as opposed to on the user interface, therefore requires laptop to operate
- Too low camera exposure time, cannot go above 0.1s
- Better camera lens not used due to issues with focal length
- Camera not stable due to resting on a box

## Prototype 2

## Prototype 2 Subsystems

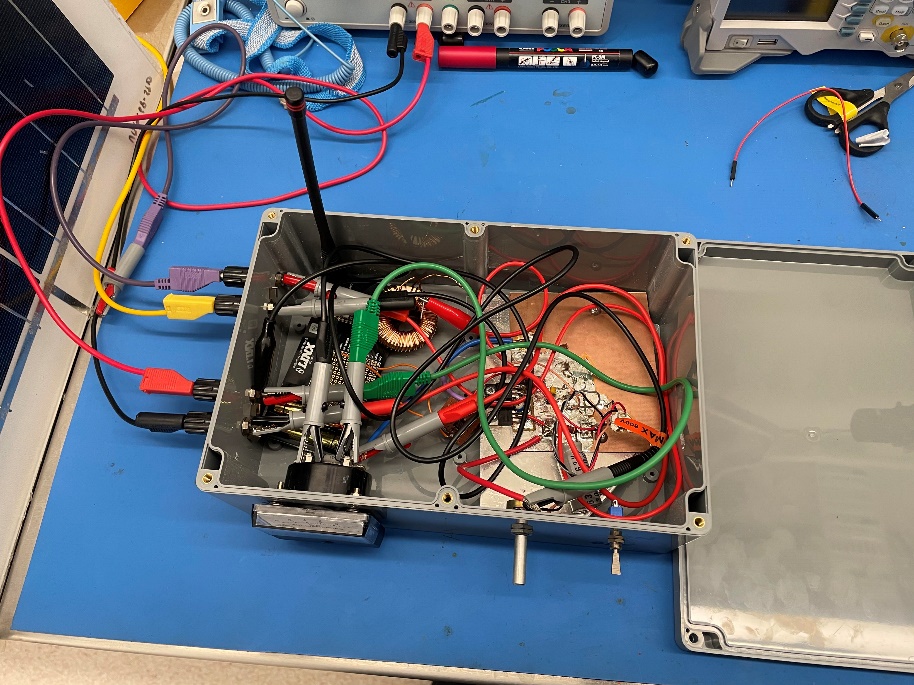
[picture p196: figure]

Current Regulator with RF link, ampmeter, external cable plugs, switch and potentiometer

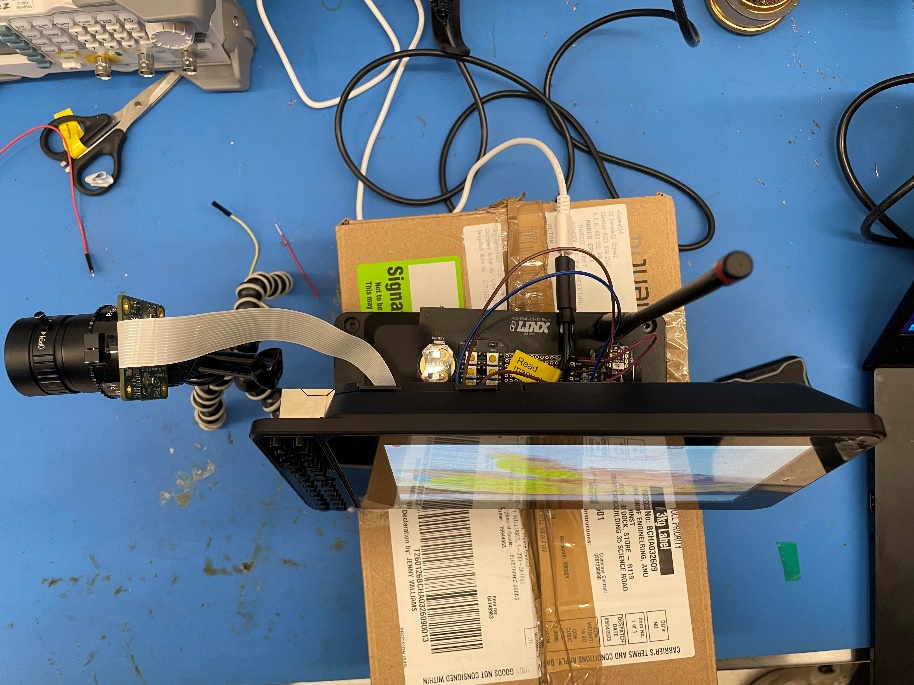
[picture p197: figure]

Camera System with RF trigger

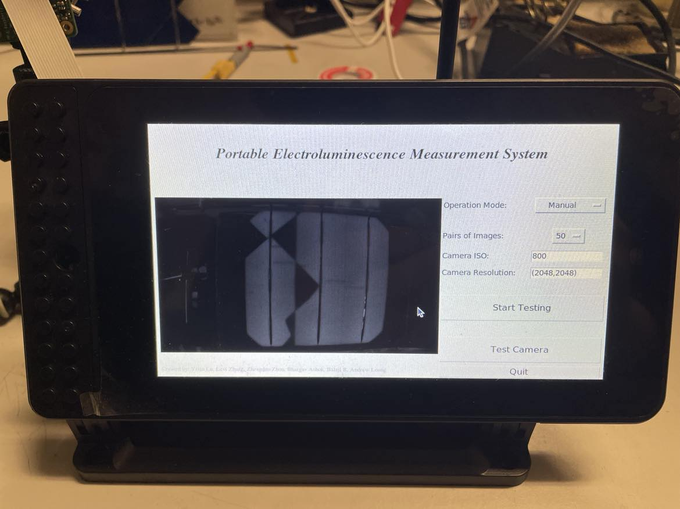
[picture p198: figure]

User Interface

## Prototype 2 Demonstration

- Video removed due to size

## Prototype 2 Results

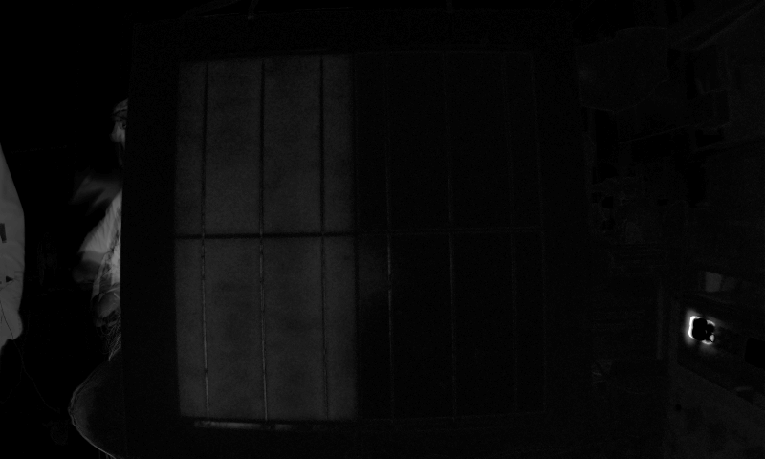
[picture p199: figure]

EL result and validation through partial powering of panel

Power on

Power off

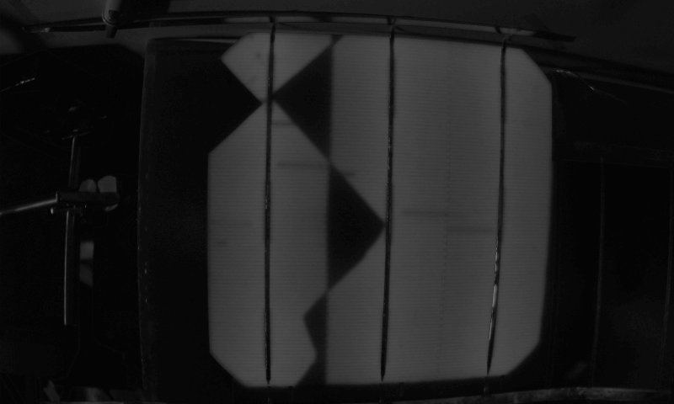
[picture p200: figure]

EL image of known broken cell. Highlights cracks and non-functional arms. Validates system results

## Prototype 2 Key Features

- Functional Individual Subsystems
  - Raspberry Pi controls timing of both image capture and current regulator using radio frequency, camera now placed on tripod for stability
  - Algorithm controllable via user interface, no laptop required
  - Current regulator fitted into appropriately sized box with RF link, built in ampmeter, switch and potentiometer.
- Able to obtain EL images using 50 pairs of images within 3 minutes
- Validated results using a known broken cell
- LED light replaced with buzzer to indicate when current is passed to panel. Reduces noise from LED

## Prototype 2 Concerns

- Exposure time of camera still too low, cannot go above 0.1s
- Better camera still not used due to issues with focal length
- System can be optimised to take pictures faster as exposure time is 0.1s but wait time for next image is 1 second.
- Image export from user interface to laptop identified. Image captured at 2K resolution but exports at 480p.
- Image taken at 8Mpixels as opposed to 12Mpixels allowed for by camera
