bradbn/pelms-2024-s1/docs/PELMS/PELMS-2024S1_Imaging_Test_Notes_24May2024.docx

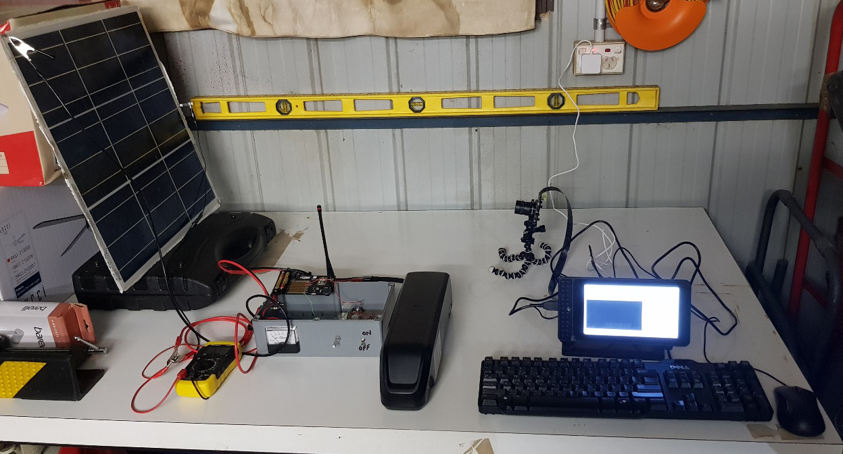
[picture p201: figure]

Photos Rotate 180

Edit Image Adjustment Tab Light Brightness 100

Light Exposure 100

Light Contrast -100

Word Format Picture Picture Picture Corrections

Brightness/Contrast

Brightness 25 %

Contrast -50 %

Position [01], [02], [03]

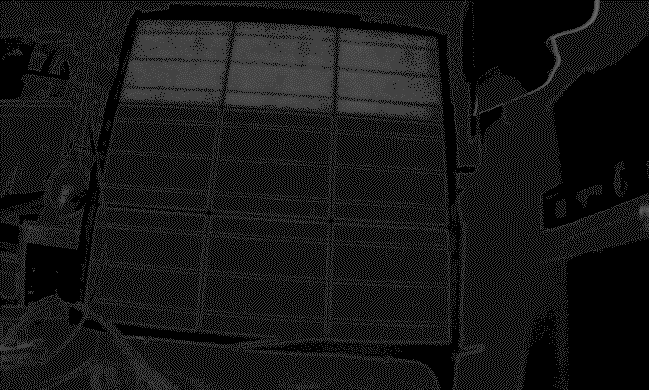
[picture p202: figure]
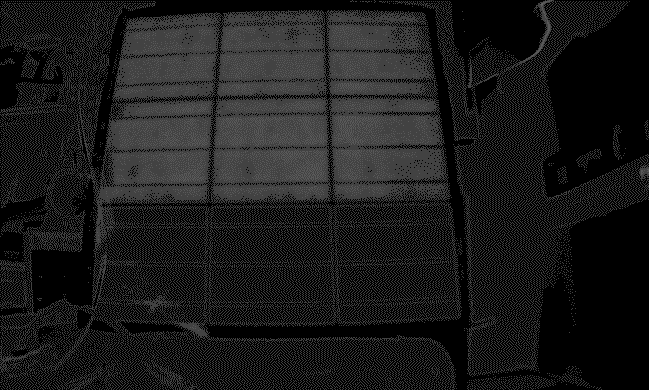
[picture p203: figure]
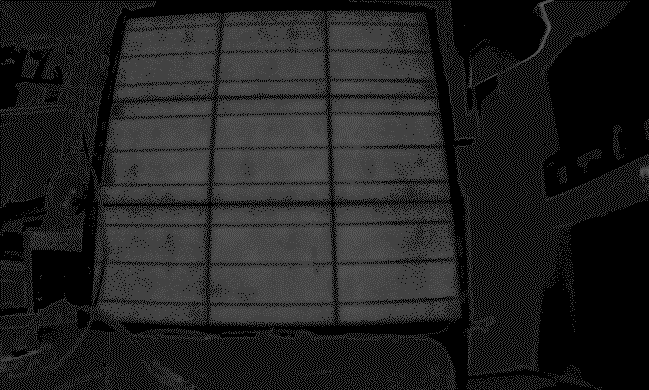
[picture p204: figure]

Current 7 A, 8 A, 9 A

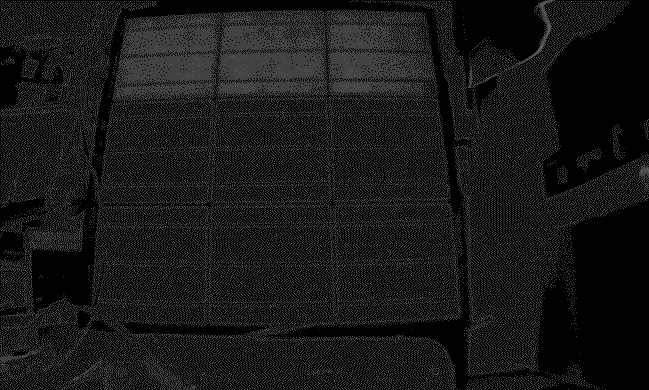
[picture p205: figure]
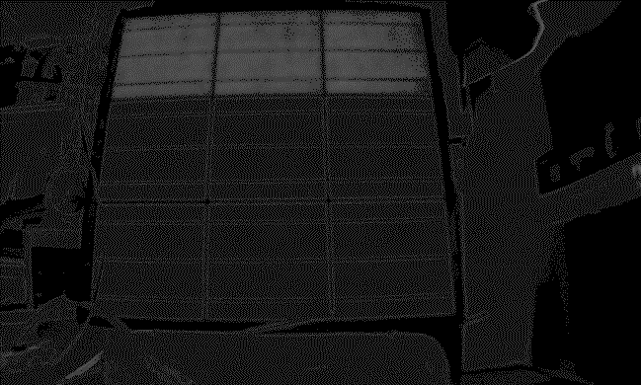
[picture p206: figure]

Pair Count: 10 20 50

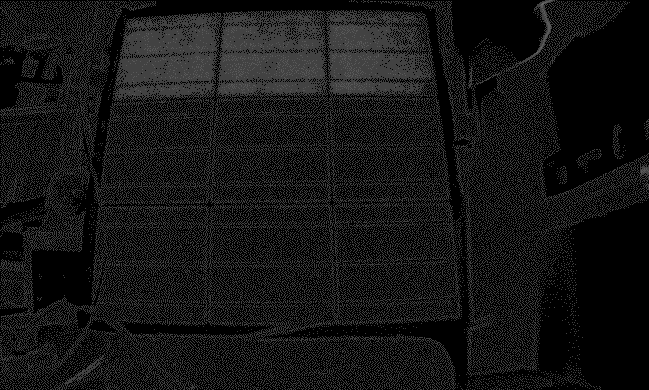
[picture p207: figure]
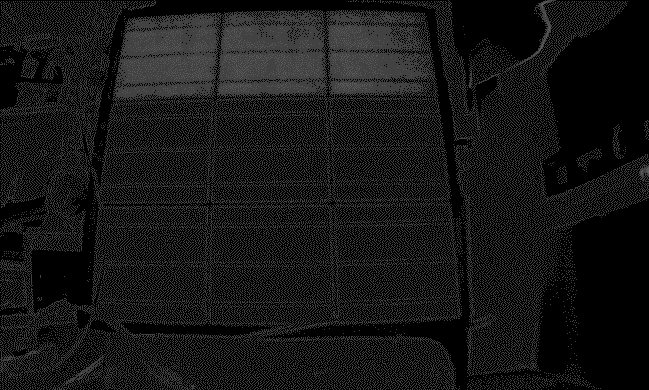
[picture p208: figure]
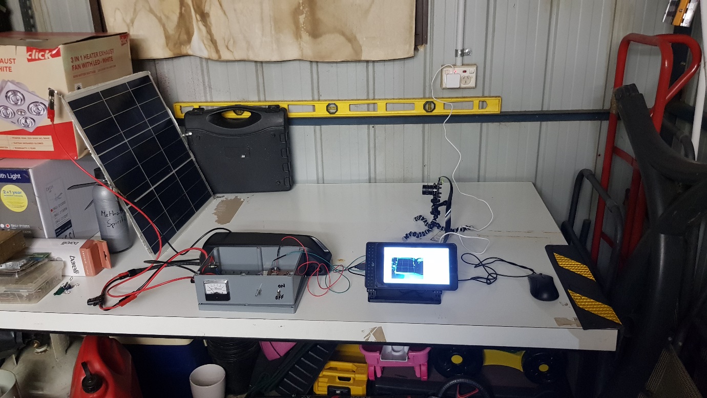
[picture p209: figure]
