bradbn/pelms-2024-s1/docs/PELMS/PELMS-2023-S1/SharePoint/Documents/Reports/Final Documents/Poster/(Submitted to TechLauncher) Final edit.pdf

# Portable "X-ray" for Solar Panels

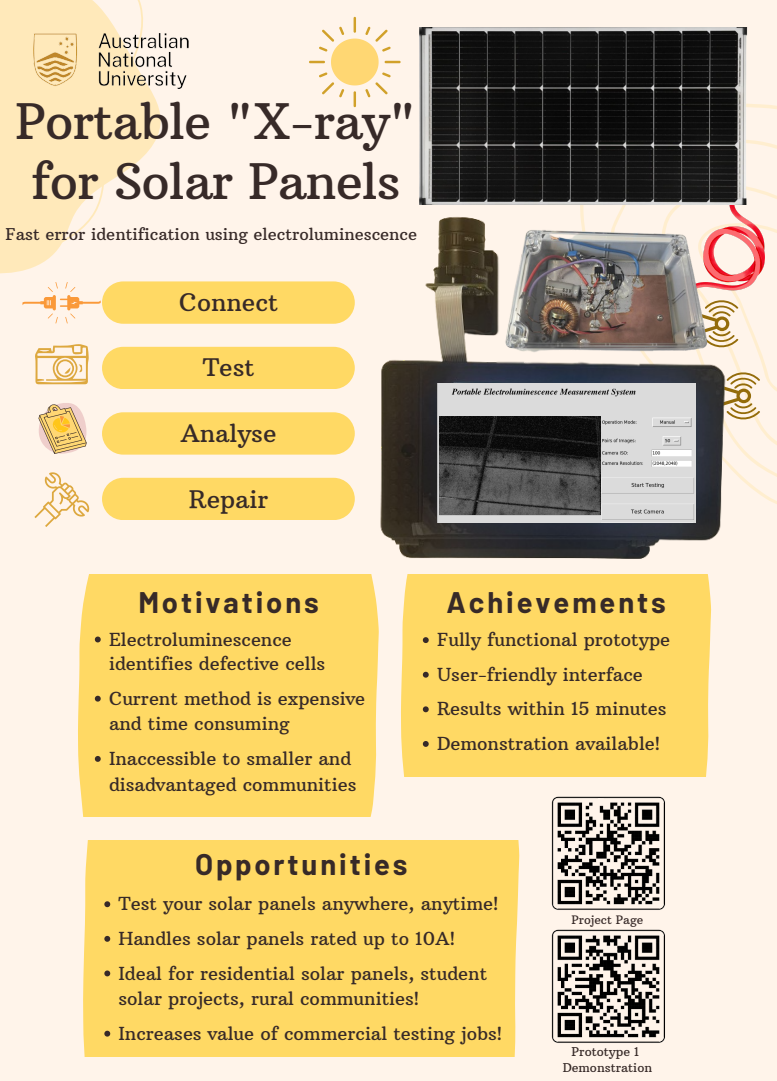
[picture p210: page 1]
Connect; Test; Analyse; Repair; Achievements; Motivations; Project Page; Opportunities; Prototype 1 Demonstration

Fast error identification using electroluminescence

Electroluminescence
identifies defective cells
Current method is expensive
and time consuming
Inaccessible to smaller and
disadvantaged communities

Fully functional prototype
User-friendly interface
Results within 15 minutes
Demonstration available!

Test your solar panels anywhere, anytime!
Handles solar panels rated up to 10A!
Ideal for residential solar panels, student
solar projects, rural communities!
Increases value of commercial testing jobs!
