bradbn/pelms-2024-s1/docs/PELMS/PELMS-2024-S1/LTSPICE_PELMS2024S1_SIM_10May2024/LT spice model hv9910c v3 - nabradb.asc

A2: dflop
C1: cap; 390e-6
C2: cap; 0.1e-6
D1: schottky; MBR20100CT
D2: schottky; MBR20100CT
D3: schottky; MBR20100CT
E1: e; 10
L1: ind; 15e-6
M1: nmos; IPA086N10N3
R1: res; 1000
R2: res; 0.01
R3: res; 1
R4: res; 0.1
S1: sw; MYSW
V1: voltage; PULSE(0 5 0 0 0 5e-9 10e-6)
V2: voltage; 5
V3: voltage; 52
V4: voltage; 0.21
Named nets: 0, gate
.tran 1e-3
.model MYSW SW(Vt=0, Vh=0, Ron=0.01, Roff=10meg)
D2: Solar Panel
D3: Solar Panel
V3: Battery Source (i.e. 52V E-Bike Battery)
R2: Current Sensing Resistor
V4: LD (Light Dimming) Voltage - controls current output level
C1: Current Regulator Circuit Output Capacitor
L1: Current Regulator Circuit Output Series Inductor
HV9910C Simulation for Current Analysis
