bradbn/pelms-2024-s1/(commit log)

2023-09-02 Adding camera_code
2023-09-03 Updating video buttons.
2024-10-21 Adding documentation docs directory.
    [1711725.psm, 1711725.stp, 4PCV-06-006.stp, 4pcv06006.psm, 640445-3.stp, EDI2CAP.CFG, Gantt Chart.xlsx, MC000048.stp]
